VedantPahariya/VLSI-Carry-Look-Ahead-Adder/Project Report.pdf

# Fastest Carry Look-Ahead Adder Design for Enhanced Computational Efficiency

Vedant Pahariya
ECD IIIT-H
2023112012
vedant.pahariya@research.iiit.ac.in

Abstract—This paper proposes the design for the fastest CLA. It mentions about all the blocks and topology used in the design. It also mentions about the simulation results and the comparison with existing designs. The design is implemented in 180nm technology. The design is compared with the existing designs and it is found that the proposed design is the fastest among all.

Index Terms—Carry Look-Ahead Adder, CLA, VLSI, Computational Efficiency, 180nm Technology, Digital Design, High-Speed Arithmetic

I. INTRODUCTION

The Carry Look-Ahead Adder (CLA) is a digital circuit that is used to add two binary numbers. It is a basic unit component for all arithmetic processes which goes in processor. Making it faster can enhance the computational efficiency of whole system. The CLA is a fast adder because it can generate the carry signals for all the bits in parallel. The CLA is faster than the Ripple Carry Adder (RCA) because the RCA generates the carry signals sequentially, faster than the Carry Select Adder (CSA) because the CSA generates the carry signals for a group of bits in parallel, faster than the Carry Skip Adder (CSKA) because the CSKA generates the carry signals for a group of bits in parallel, faster than the Carry Increment Adder (CIA) because the CIA generates the carry signals for a group of bits in parallel.

II. CARRY LOOK-AHEAD ADDER DESIGN

CLA design consists of three blocks: the Propagate & Generate block, Carry Look Ahead (CLA) block and Sum block. The Propagate & Generate block gives carry generate (Gi) and propagate generate (Pi) signal for every i

th bit of inputs. The
output of this block is used in CLA block to generate Carry Ci which is then utilised in the Sum block to get the Sum output. The basic CLA design is based on the following equations:

Gi = Ai

- Bi | (1)
Pi = Ai ⊕ Bi | (2)

Ci = Gi + Pi

- Ci−1 | (3)

where Gi
is the Generate signal, Pi is the Propagate signal,
Ci

is the Carry signal, Ai
is the i

th bit of the first number, Bi is the i

th bit of the second number, and Ci−1 is the (i − 1)th Carry signal.

Here, we are focusing on the 4-bit CLA design. Therefore, using recursive approach for carry in above equations, we can write the equations for the 4-bit CLA design as follows:

C0 = G0 + P0 · Cin | (4)

C1 = G1 + P1 · C0
= G1 + P1 · (G0 + P0 · Cin)
= G1 + P1 · G0 + P1 · P0 · Cin | (5)

C2 = G2 + P2 · C1
= G2 + P2 · (G1 + P1 · (G0 + P0 · Cin))
= G2 + P2 · G1 + P2 · P1 · G0 + P2 · P1 · P0 · Cin (6)

C3 = G3 + P3 · C2
= G3 + P3 · (G2 + P2 · (G1 + P1 · (G0 + P0 · 0)))
= G3 + P3 · G2 + P3 · P2 · G1 + P3 · P2 · P1 · G0 (7)

where Ci

, Gi
, and Pi are the Carry, Generate, and Propagate signals for the i

th bit, respectively. Cin is the input Carry signal.

A. Improving the Basic CLA Design

The above basic CLA design can be improved extensively by making the following changes:
1) Use of OR gate instead of XOR gate for Propagate block: XOR gate can be replaced by OR gate which can be further reduced to the NOR logic for the Propagate block to reduce the number of gates in the design. The Propagate block can be designed as follows:
Pi = Ai + Bi | (8)

To demonstrate that both XOR and OR gates give the same results for the Propagate block, we can see in the following truth table that results are same for both XOR and OR gates except when both inputs are 1.

TABLE I
TRUTH TABLE FOR XOR AND OR GATES
Ai | Bi | Ai ⊕ Bi (XOR) | Ai + Bi (OR)
0 | 0 | 0 | 0
0 | 1 | 1 | 1
1 | 0 | 1 | 1
1 | 1 | 0 | 1

In case of carry generation, when both inputs are High (1), that is both Ai = 1 and Bi = 1:

Gi = Ai

- Bi = 1 · 1 = 1
Ci = Gi + Pi
- Ci−1
= 1 + Pi
- Ci−1
= 1 (regardless of Pi and Ci−1)

Therefore, when both inputs are 1, the carry signal is always generated (Ci = 1) regardless of the value of the propagate signal (Pi) or the previous carry (Ci−1).
As shown above, for the purpose of carry propagation in the CLA design, the OR gate can be used in place of XOR to reduce the number of gates.
2) Modification of the equations for the Carry signals to reduce the number of gates: The equations for the Carry signals for basic CLA use AND and OR gates which inherently includes two extra transistors for each gate becuase of the presence of the inverter. The number of gates can be reduced by modifying the logic such that it uses NAND and NOR gates in place of AND and OR wherever possible. Starting with simplification of C1, we know that:

C1 = G0 + P0 · C0

Here, we can convert AND gate between P0, C0 to NOR gate as shown below:

C1 = G0 +

P

′
0 + C0

Further, we can convert OR gate to NAND gate as shown below:
C1 = G′
0
P

′
0 + C0

Similarly, for the other carry signals, the modified equations can be written as follows:

C1 = G′
0
P

′
0 + C0
(9)

C2 = G′
1

(P

′

1 + G′
0

) +
P

′
1 + P

′
0
C0 | (10)

C3 = G′
2

(P

′

2 + G′
1

) +
P

′
2 + P

′
1
G′
0
P

′
0 + C0
(11)

G

′
out = G′
3

(P

′

3 + G′
2

) +
P

′
3 + P

′
2
G′
1

(P

′

1 + G′
0

) (12)

P

′
out = (P

′
3 + P

′
2

)(P

′
1 + P

′
0
) | (13)

C4 = G′
out
P

′
out + C0
| (14)

where G′
i

and P

′
i

are the modified Generate and Propagate signals for the i

th bit, respectively.

B. Topology and Sizing of Each Block
Based on the equations and logic functions derived above, the topology of the 4-bit CLA design can be implemented as shown in the figure below. The design is implemented in 180nm technology. The sizing of the transistors in each block is done considering the speed of the design. I have followed the CMOS logic for all the logic gates except XOR. For XOR, I used Pass Transistor Logic because it uses less no. of transistors. Here, I implemented the method of logical effort for sizing each block as following:

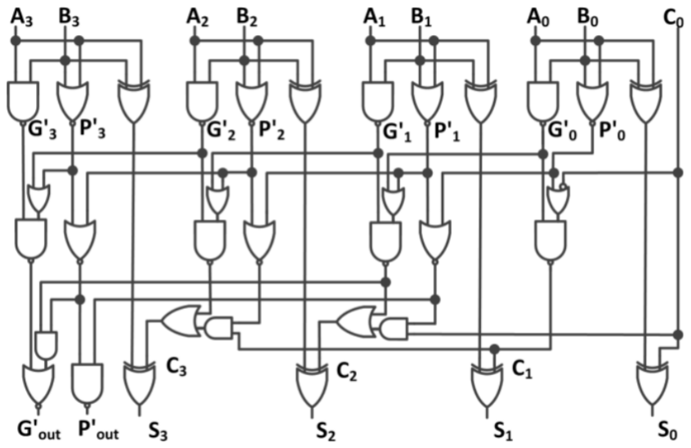
[picture p2: figure]

Fig. 1. 4-bit Carry Look-Ahead Adder Design

1) Propagate & Generate Block: This block includes three gates for each carry bit: One NOR gate for the Propagate signal, one NAND gates for the Generate signal and one XOR gate for the Sum signal.

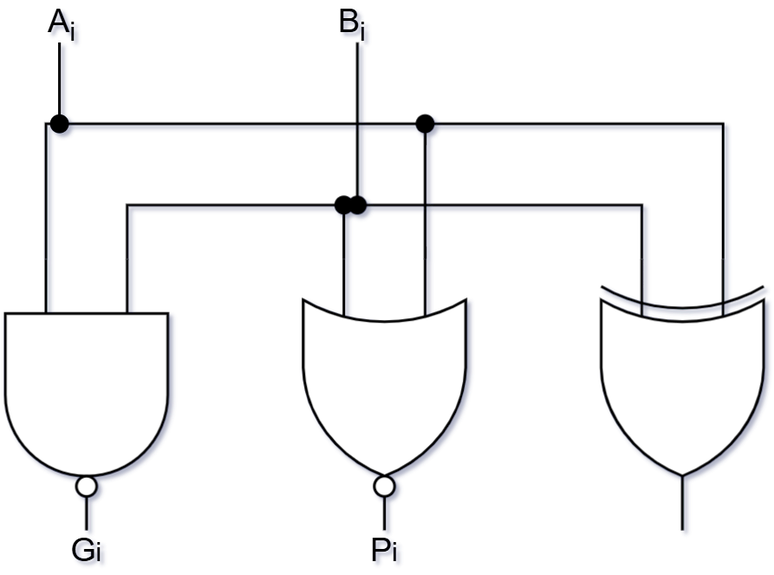
[picture p3: figure]

Fig. 2. Propagate & Generate Block

Accoroding to the method of logical effort, the size of these gates is larger i.e. just double the proceedings gates of the intermediate block of CLA. So, the table below shows the sizing of gates in this block:

TABLE II
SIZING OF GATES IN PROPAGATE & GENERATE BLOCK
Gate | Width (WN /WP ) (µm) | Length (µm) | Number of Gates
NOR | 3.6 / 7.2 | 0.18 | 4
NAND | 3.6 / 3.6 | 0.18 | 4
XOR | 0.36 / 0.72 | 0.18 | 4
2) Carry Look Ahead Block: This block again further divided into two more subblocks namely intermediate block and AndOr block. The intermediate and the AndOr block includes three gates and two gates respectively for each carry bit. The intermediate block includes a NOR gate, NAND and OR gate and the AndOr block includes one AND gate and one OR gate.

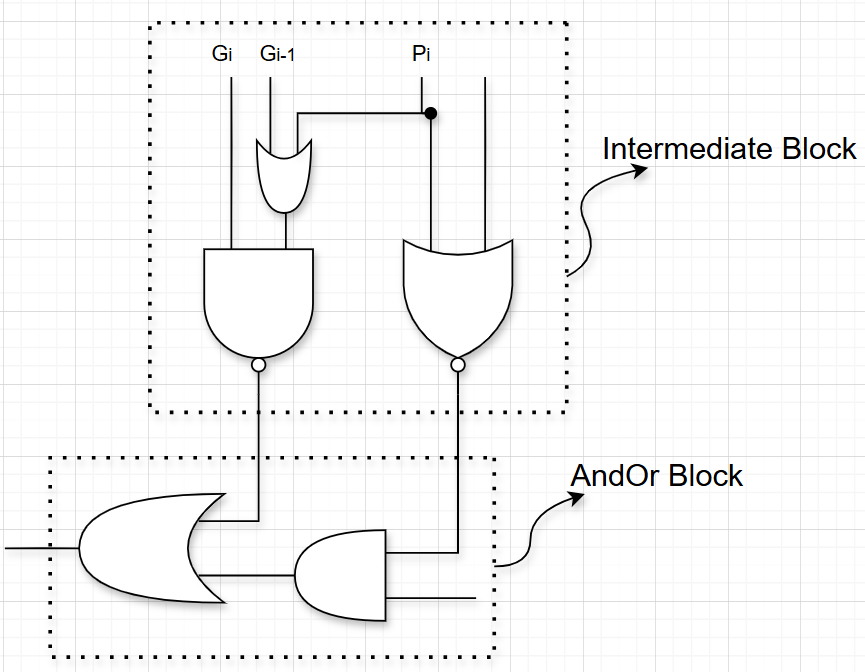
[picture p4: figure]

Fig. 3. Carry Look Ahead Block for Single Carry Bit

The sizing of gates in the intermediate and AndOr block is done as per the method of logical effort. As a result, also mentioned in the previous block that this block sizing is half of the propagate & generate block sizing. The OR gate is implemented using the NOR gate with an inverter at the output. Similarly for the AND gate, the NAND gate is used with an inverter at the output. The table below shows the sizing of gates in these blocks:

TABLE III
SIZING OF GATES IN INTERMEDIATE AND ANDOR BLOCKS
Block | Gate | Width (WN /WP ) (µm) | Length (µm)
Intermediate | NOR | 0.9 / 1.8 | 0.18
| NAND | 1.8 / 1.8 | 0.18
| OR | 0.9 / 1.8 | 0.18
AndOr | AND | 1.8 / 1.8 | 0.18
| OR | 0.9 / 1.8 | 0.18
Inverter | - | 0.9 / 1.8 | 0.18
3) Sum Block: This block includes single XOR gate for the Sum signal which is implemented using Pass Transistor Logic. The sizing of this is set to be least possible just enough to drive the W-sized inverter and satisfy the DRC constraints because it is the last block in the design and don’t have to drive any other block.

Fig. 4. Sum Block

TABLE IV
SIZING OF GATES IN SUM BLOCK
Gate | Width (WN /WP ) (µm) | Length (µm) | Number of Gates
XOR | 0.36 / 0.72 | 0.18 | 6
4) D-Flip Flop: It is implemented using the True Single Phase Clocked (TSPC) technology. It includes total no. of 12 transistors in CMOS logic style. The sizing of this is done by equating the resistances with the minimum W-sized inverter. There are two parts in the postive edge trigerred TSPC D-Flip Flop: Low-Level Latch and High-Level Latch.

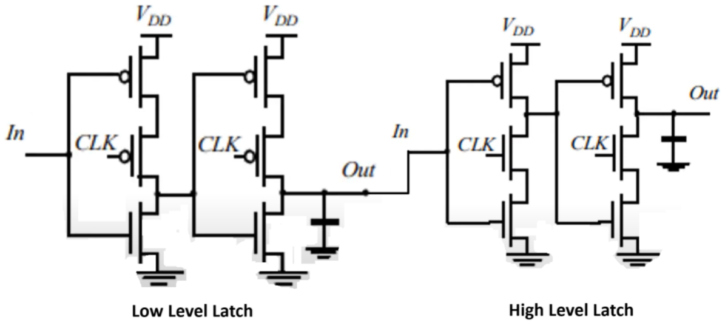
[picture p5: figure]

Fig. 5. TSPC D-Flip Flop

TABLE V
SIZING OF TRANSISTORS IN TSPC D-FLIP FLOP
Block | Transistor | Width (µm) | Length (µm)
Low-Level Latch | PMOS | 3.6 | 0.18
| NMOS | 0.9 | 0.18
High-Level Latch | PMOS | 1.8 | 0.18
| NMOS | 1.8 | 0.18

III. DELAY CHARACTERISTICS OF D-FLIP FLOP (PRELAYOUT)

The TSPC D Flip-Flop was simulated using NGSPICE with a clock period of 2ns and input period of 4ns. Both clock and input signals were given sharp rise/fall times of 50ps to analyze the flip-flop’s delay characteristics.

A. Clock to Q Delay

Upon simulating, we observe the following waveforms and terminal outputs:

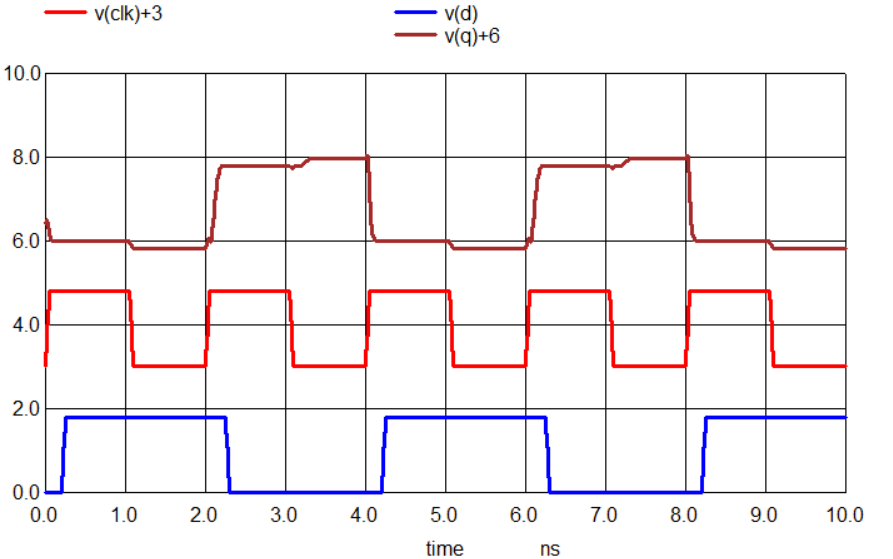
[picture p6: figure]

Fig. 6. Waveforms Output of D-Flip Flop

Fig. 7. Terminal Output for Delay

The simulation gives the following timing parameters:

- Rise Delay: 91.58ps - Time taken for the output to rise after the triggering clock edge
- Fall Delay: 30.77ps - Time taken for the output to fall after the triggering clock edge
- Average Propagation Delay: 61.17ps - Mean of rise and fall delays

The asymmetry between rise and fall delays (ratio ≈ 3:1) can be attributed to:

- Different sizing of PMOS/NMOS transistors in the low-level and high-level latches
- Inherent mobility difference between PMOS and NMOS devices
- Cascaded structure of the latches affecting signal propagation paths
B. Setup Time

Setup time (tsetup) is the minimum time before the active clock edge during which the data input (D) must remain stable. For TSPC D flip-flop, setup time is equal to the propagation delay of the Low-Level Latch because when clock is low, the Low-Level Latch is active and as it rises to high, the correct stable value of D must be present at the output of the Low-Level Latch for ensuring correct operation. This stable value of D appears at the output of the Low-Level Latch after the propagation delay of the Low-Level Latch.

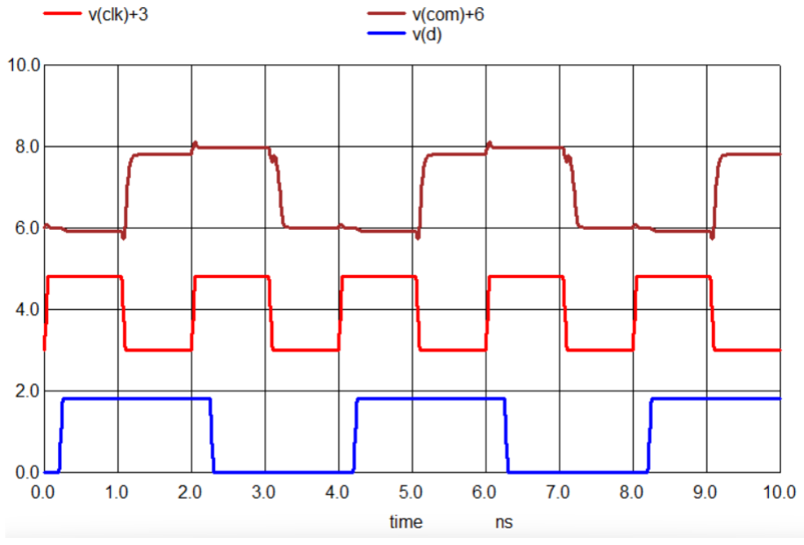
[picture p7: figure]

Fig. 8. Waveforms Output of Low-Level Latch

Fig. 9. Terminal Output for Setup Time

C. Hold Time

Hold time (thold) is the minimum time after the active clock edge during which the data input must remain stable. For TSPC D flip-flop, hold time is zero because the High-Level Latch is active when the clock is high and the output of the High-Level Latch is not dependent on the input D when the clock is high. Therefore, the input D can change immediately after the active clock edge without affecting the output Q.

TABLE VI
TIMING CHARACTERISTICS OF TSPC D-FLIP FLOP
Parameter | Value (ps)
Rise Delay | 91.58
Fall Delay | 30.77
Propagation Delay | 61.17
Setup Time | 87.65
Hold Time | 0

IV. STICK DIAGRAM OF UNIQUE GATES

A. Inverter

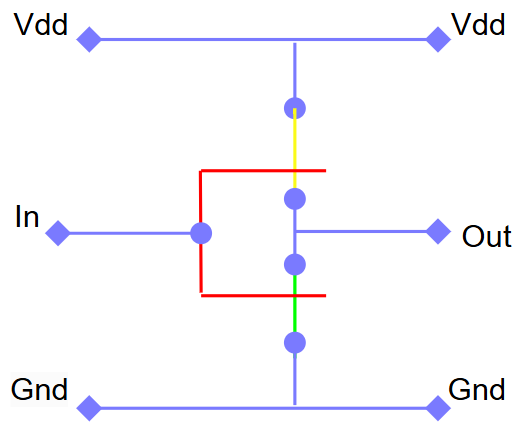
[picture p8: figure]

Fig. 10. Inverter Stick Diagram

B. NOR Gate

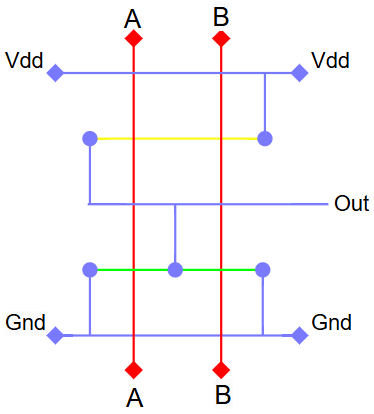
[picture p9: figure]

Fig. 11. NOR Gate Stick Diagram

C. NAND Gate

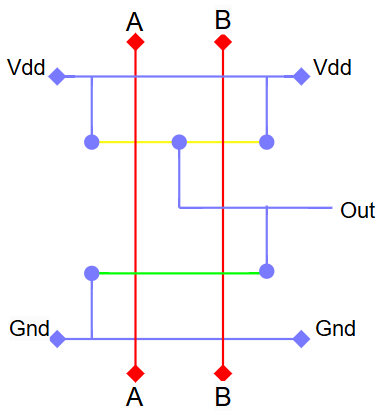
[picture p10: figure]

Fig. 12. NAND Gate Stick Diagram

D. XOR Gate

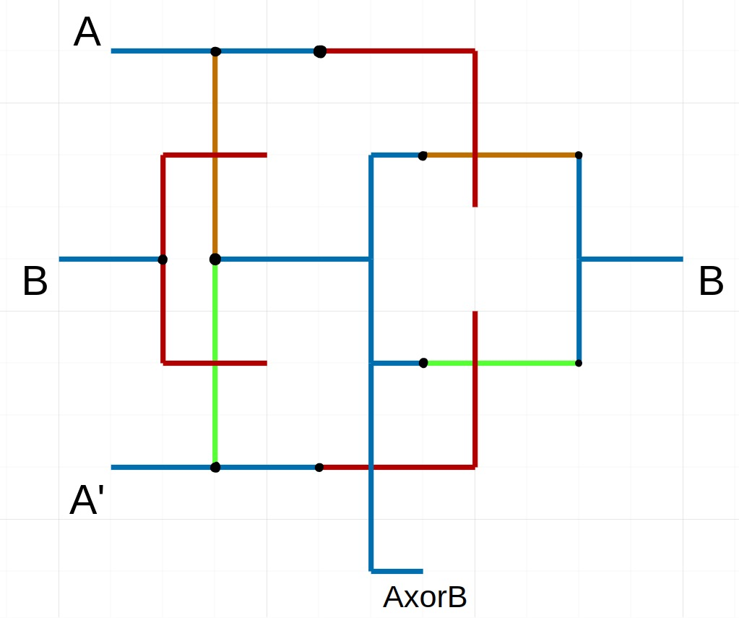
[picture p11: figure]

Fig. 13. XOR Gate Stick Diagram

V. PRELAYOUT SIMULATION RESULTS & ANALYSIS OF
CLA
The 4-bit Carry Look-ahead Adder was simulated using NGSPICE with the following test conditions:
A. Verification of functionality
1) Input Specifications:
- Supply Voltage (VDD): 1.8V
- Input A (4-bit):

– A0: Pulse starting at 10ns, Period = 40ns – A1: Pulse starting at 15ns, Period = 50ns – A2: Pulse starting at 20ns, Period = 60ns – A3: Pulse starting at 25ns, Period = 70ns – Rise/Fall times: 50ps
- Input B (4-bit):
– B0: Pulse starting at 12ns, Period = 44ns – B1: Pulse starting at 18ns, Period = 56ns – B2: Pulse starting at 24ns, Period = 68ns
– B3: Pulse starting at 30ns, Period = 80ns
– Rise/Fall times: 50ps
- Carry Input (Cin): Pulse starting at 36ns, Period = 88ns
- Clock (CLK): Period = 8ns
2) Output Analysis: The simulation produces the following outputs:
- Sum outputs (S0-S3): Generated through XOR combinations of inputs and internal carries
- Final Carry (C4): Represents the overflow from the 4-bit addition

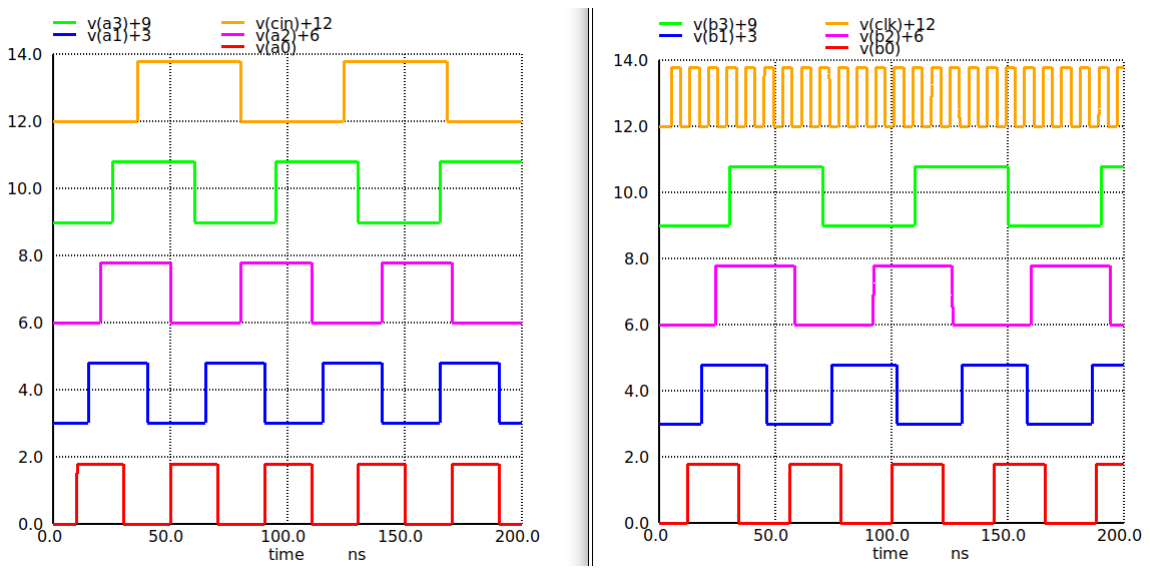
[picture p12: figure]

Fig. 14. Input Waveform

Above plots show the input waveforms given to the 4-bit CLA. The left plot shows the A bits along with Cin and right one shows the B bits along with the clock.

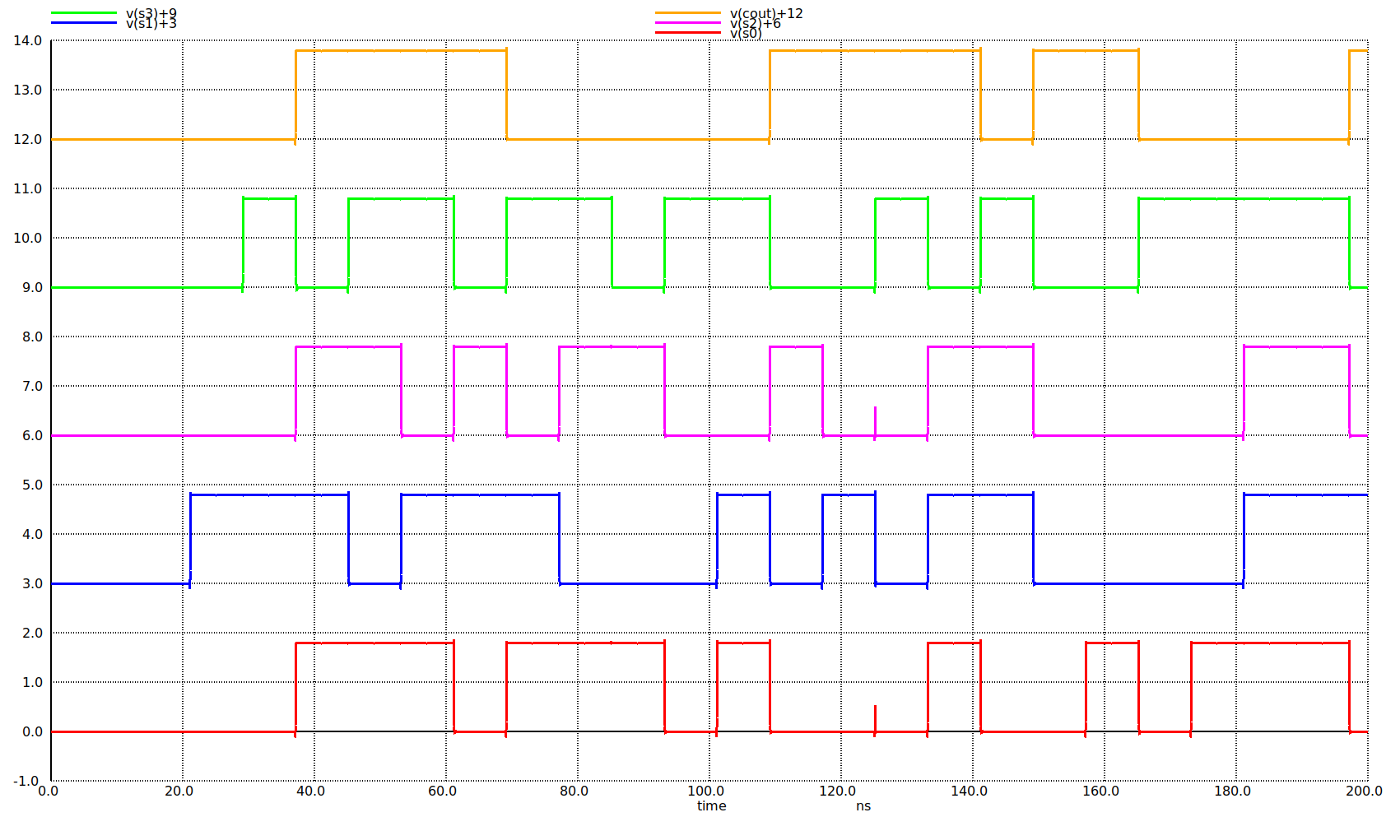
[picture p13: figure]

Fig. 15. Output Waveform

Above plot shows the output waveforms which includes the four Sum bits and the final Carry bit.
The waveforms demonstrate correct operation of the CLA with proper carry propagation and sum generation across all bit positions. The progressive delays in input signals help verify the adder’s functionality under varying timing conditions.
B. Worst Case Delay of CLA Adder Block

Worst case delay is the maximum time taken for the output to stabilize after the input changes. This happens in the path which has highest resistance or very large number of gates. In the 4-bit CLA design proposed above, the worst case delay is observed in the carry propagation path from B0 through C3 to S3 because it is the longest path with total 9 gates in midway. For considering the worst case delay, the S3 bit must change when B0 bit changes. So, here we take the input signals as follows:
- A0 = A1 = A2 = A3 = 0, B1 = B2 = 1, B3 = 0
- B0: Pulse starting at 25ns, Period = 70ns
- Cin = 1
- Clock (CLK): Pulse starting at 0ns, Period = 8ns
With the above inputs, we get the simulation results for the worst case delay as follows:

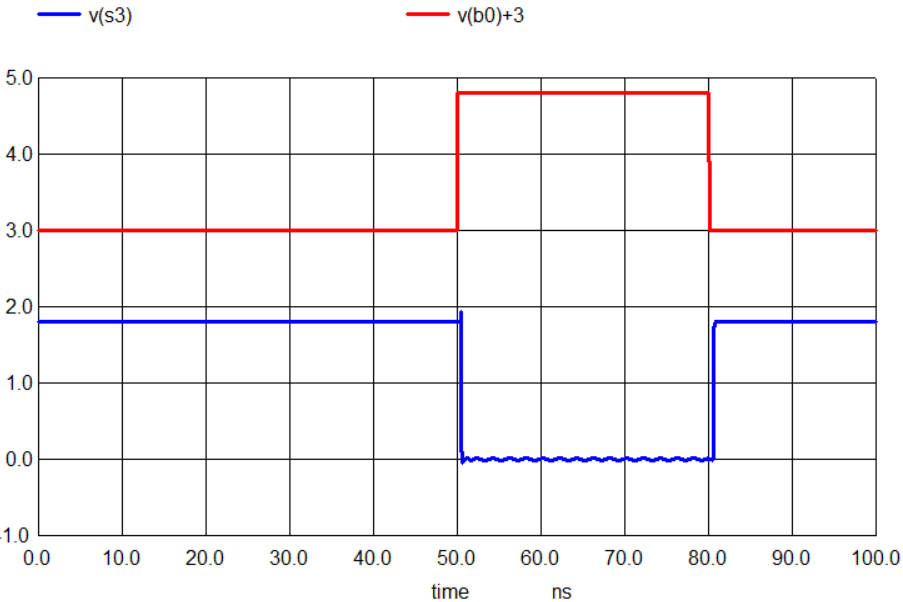
[picture p14: figure]

Fig. 16. WaveForms for the Worst Case Delay

Fig. 17. Worst Case Delay Terminal Output

The simulation results show that the worst case delay for the 4-bit CLA design is 479.16ps. This delay is observed in the carry propagation path from B0 through C3 to S3.

C. Maximum Clock Speed
1) Theoritical Calculation: The maximum clock speed of the 4-bit CLA design can be calculated using the following inequality:
tCQ1 + tpd + tsu ≤ Tclk | (15)

fmax =

1 tCQ1 + tpd + tsu | (16)

where tCQ1

is the clock-to-Q delay of the first flip-flop, tpd is the worst-case propagation delay of the CLA adder block, and tsu is the setup time of the flip-flop.
Given the values we calculated earlier:
- tCQ1 = 61.17 ps
- tpd = 479.16 ps
- tsu = 87.65 ps

The maximum clock frequency is:

fmax =

1
61.17 ps + 479.16 ps + 87.65 ps

≈ 1.59 GHz

(17)
2) Found using Simulation: Using the Ngspice Simulation, I found that the maximum clock frequency of the 4-bit CLA design is 1.04 GHz which is less than the theoritical value. This difference can be attributed to the following factors:
- Parasitic Capacitances: The simulation does not consider the parasitic capacitances which can affect the delay and hence the maximum clock frequency.
- Wire Delays: The simulation does not consider the wire delays which can affect the delay and hence the maximum clock frequency.

VI. DELAY CHARACTERISTICS OF D-FLIP FLOP (POSTLAYOUT)

The TSPC D Flip-Flop was simulated using NGSPICE with a clock period of 2ns and input period of 4ns. Both clock and input signals were given sharp rise/fall times of 50ps to analyze the flip-flop’s delay characteristics.

A. Clock to Q Delay

Upon simulating, we observe the following waveforms and terminal outputs:
The simulation gives the following timing parameters:
- Rise Delay: 92.21ps - Time taken for the output to rise after the triggering clock edge
- Fall Delay: 24.09ps - Time taken for the output to fall after the triggering clock edge
- Average Propagation Delay: 53.15ps - Mean of rise and fall delays
- Setup Time: 67.43ps - Minimum time before the active clock edge during which the data input must remain stable
- Hold Time: 0ps - Minimum time after the active clock edge during which the data input must remain stable

VII. POST-LAYOUT SIMULATION RESULTS & ANALYSIS
OF CLA

The 4-bit CLA desgign layout was implemented in 180nm technology in magic as shown in the figure below. The layout was then extracted and simulated using NGSPICE with the same test conditions as the pre-layout simulation.


Fig. 18. Magic Layout of 4-bit CLA Design

A. Verification of functionality

The input and output specifications are same as mentioned previously in the prelayout simulation. The post-layout simulation produces the following outputs:

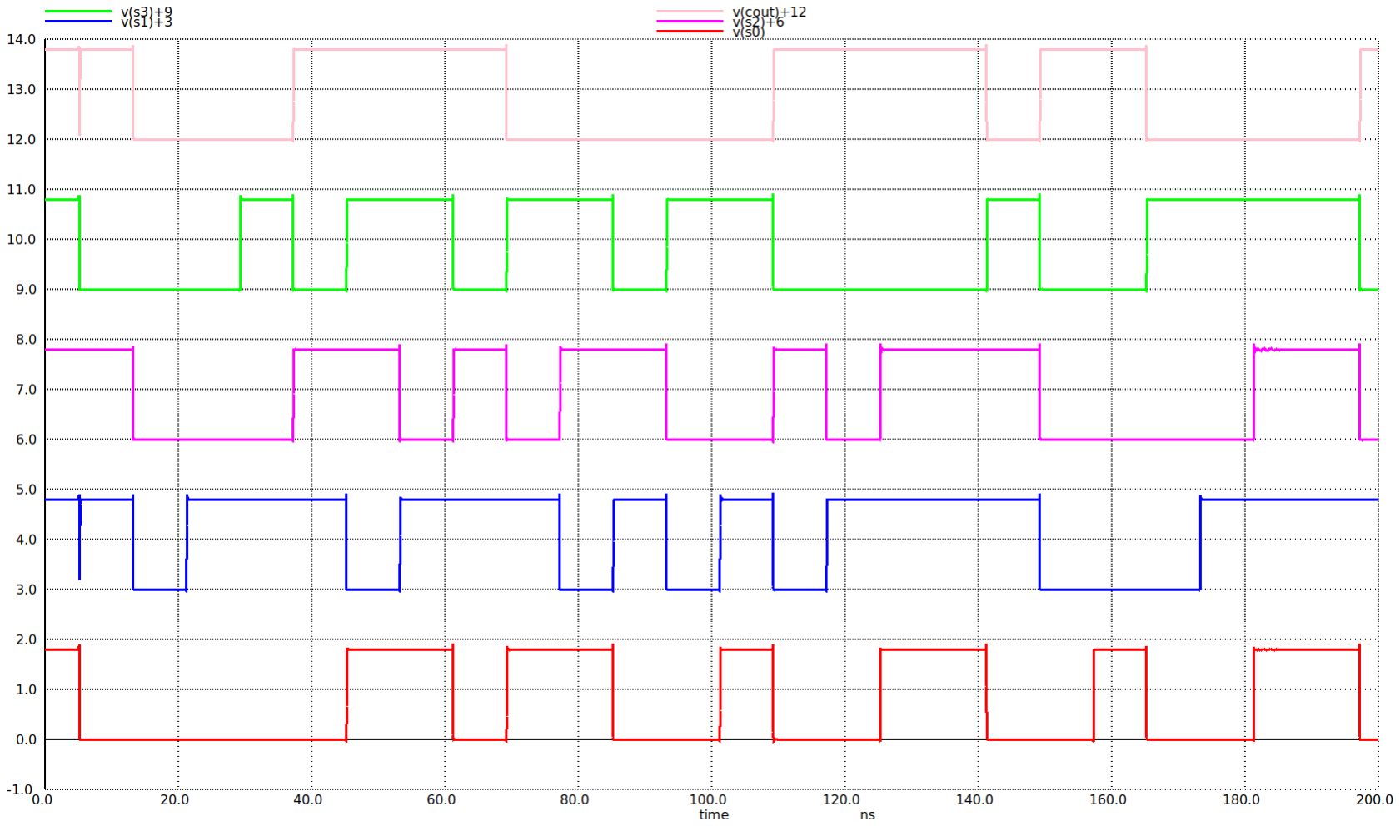
[picture p15: figure]

Fig. 19. Input Waveform

The intial outputs are different from the prelayout simulation because of the initial conditions of the flip-flops. After few clock cycles, the outputs stabilize and matches exactly with the prelayout simulation hence the correct operation of the CLA is verified.

B. Worst Case Delay of CLA Adder Block

The worst case delay of the post-layout 4-bit CLA design is calculated using the same inputs as in the pre-layout simulation. The simulation results for the worst case delay are as follows:

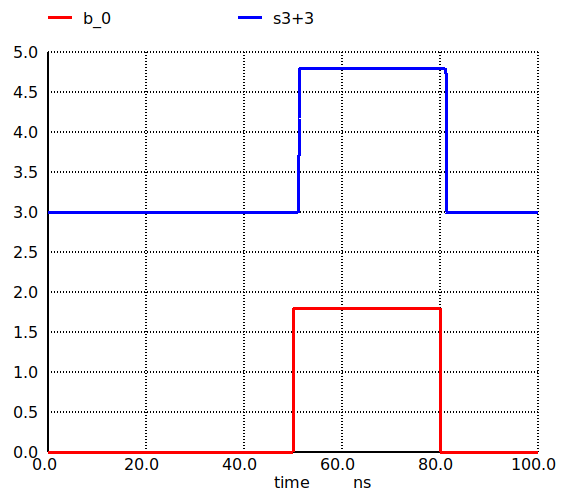
[picture p16: figure]

Fig. 20. WaveForms for the Worst Case Delay

Fig. 21. Worst Case Delay Terminal Output

The simulation results show that the worst case delay for the post-layout 4-bit CLA design is 1112.62ps. This delay is observed in the carry propagation path from B0 through C3 to S3.

C. Maximum Clock Speed

The maximum clock speed of the post-layout 4-bit CLA design is calculated using the same method as in the pre-layout simulation. Given the values we calculated earlier:

- tCQ1 = 53.15 ps
- tpd = 1112.62 ps
- tsu = 67.43 ps

The maximum clock frequency is:

fmax =

1
53.15 ps + 1112.62 ps + 67.43 ps

≈ 0.81 GHz

(18)
By using the simulation, we found out the similar results as calculated above. The maximum clock frequency of the post-layout 4-bit CLA design is 0.81 GHz.

TABLE VII
COMPARISON OF PRE AND POST LAYOUT SIMULATION RESULTS
Parameter | Pre-Layout | Post-Layout
Worst Case Delay (ps) | 479.16 | 1112.62
Maximum Clock Frequency (GHz) | 1.59 | 0.81

VIII. FLOOR PLAN FOR COMPLETE CIRCUIT LAYOUT

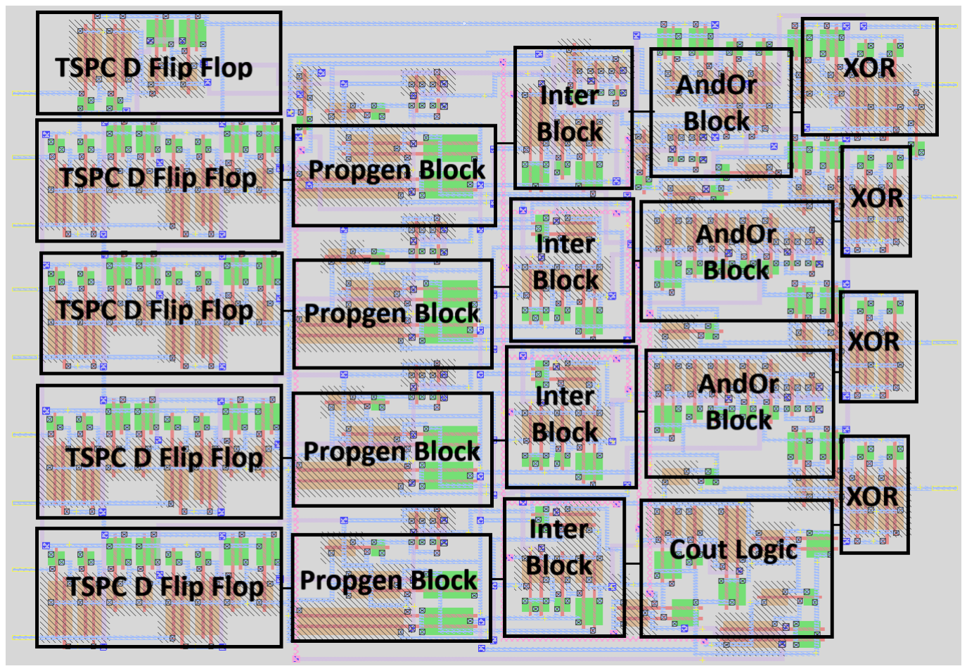
[picture p17: figure]

Fig. 22. Floor Plan for Complete Circuit Layout

The floor plan for the complete circuit layout is shown in the figure above. The layout is divided into four blocks: Propagate & Generate, Intermediate, AndOr, and Sum/XOR. The blocks are placed in a compact and organised manner to minimize the area of the layout. The Vertical and Horizontal pitch of the layout is shown in the figure below:

Fig. 23. Horizontal and Vertical pitch

From the above figure data, the area of the complete circuit layout is calculated as follows:

Area = Horizontal Pitch × Vertical Pitch
= 61.56µm × 43.83µm
= 2698.18µm²

IX. VERILOG HDL SIMULATION RESULTS

This GTKWave plot illustrates the simulation of a 4-bit Carry-Lookahead Adder (CLA). The inputs are:
- A[3 : 0]: A 4-bit binary number. - B[3 : 0]: Another 4-bit binary number. - Cin: The carry-in input.
The outputs are:
- S[3 : 0]: The 4-bit sum. - Cout: The carry-out signal. For example, at t = 0 ns:

A = 8 (10002), B = 7 (01112), Cin = 1.

The resulting sum is:

S = A + B + Cin = 8 + 7 + 1 = 16 (100002).

This gives:

S[3 : 0] = 0 (lower 4 bits), Cout = 1 (carry-out).

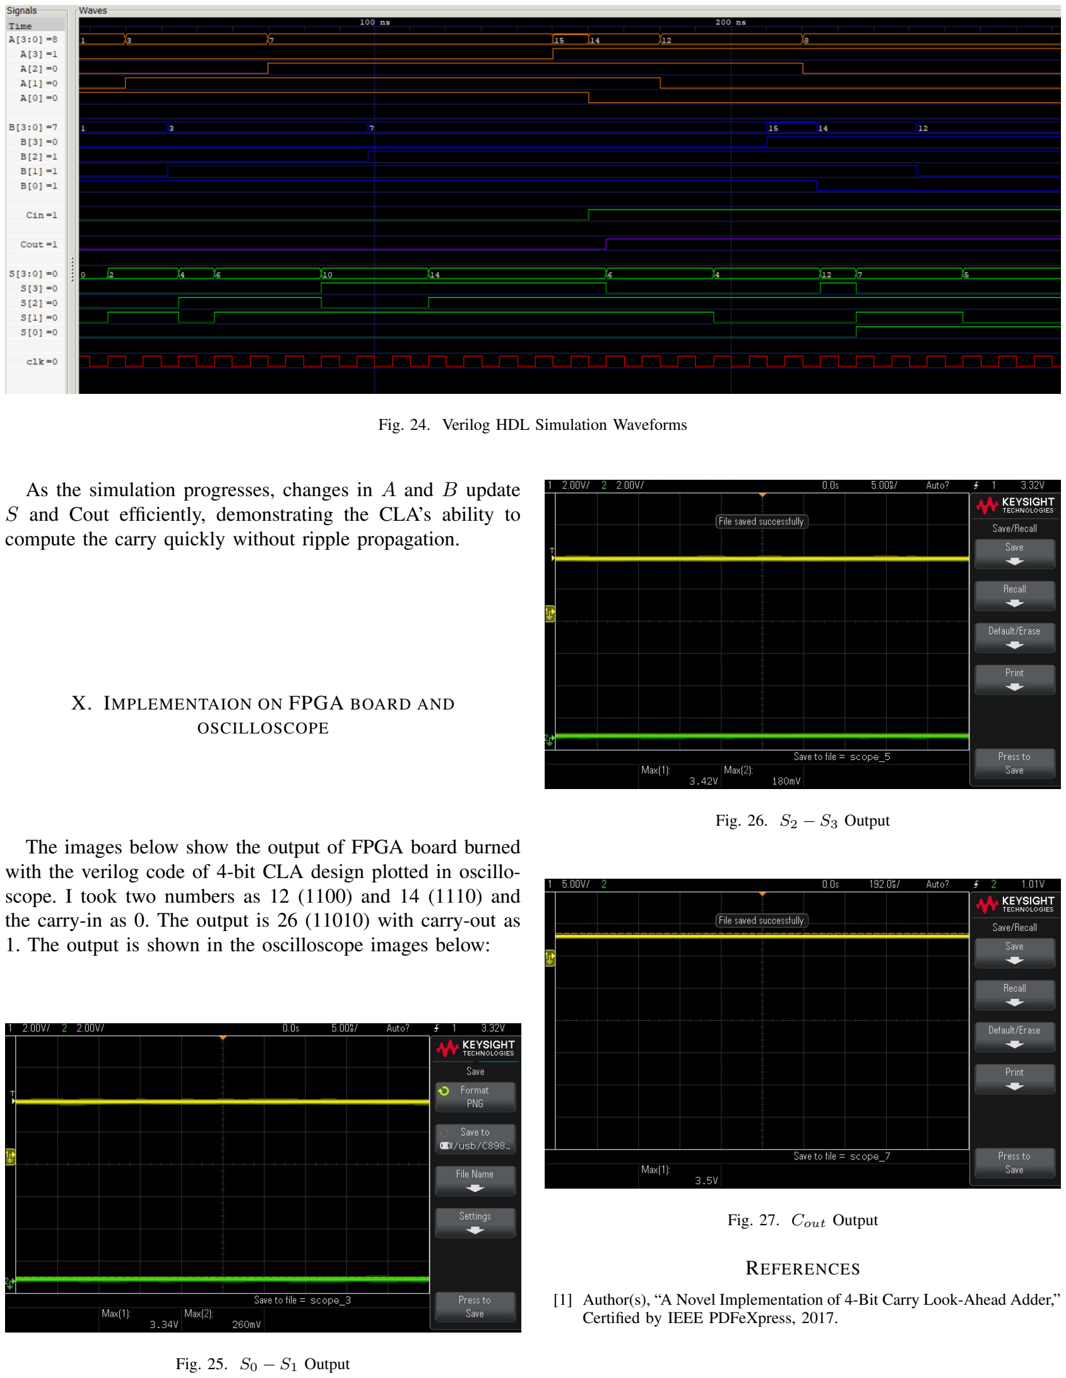
[picture p18: page 9]

Fig. 24. Verilog HDL Simulation Waveforms

As the simulation progresses, changes in A and B update S and Cout efficiently, demonstrating the CLA’s ability to compute the carry quickly without ripple propagation.

X. IMPLEMENTAION ON FPGA BOARD AND

OSCILLOSCOPE

The images below show the output of FPGA board burned with the verilog code of 4-bit CLA design plotted in oscilloscope. I took two numbers as 12 (1100) and 14 (1110) and the carry-in as 0. The output is 26 (11010) with carry-out as
1. The output is shown in the oscilloscope images below:

Fig. 25. S0 − S1 Output

Fig. 26. S2 − S3 Output

Fig. 27. Cout Output

REFERENCES

[1] Author(s), “A Novel Implementation of 4-Bit Carry Look-Ahead Adder,” Certified by IEEE PDFeXpress, 2017.
