VedantPahariya/VLSI-Carry-Look-Ahead-Adder/Magic/TSPC2.cir

.include TSMC_180nm.txt
.param SUPPLY=1.8
.global gnd vdd

* Supply
Vdd vdd gnd 'SUPPLY'

* SPICE3 file created from TSPC2.ext - technology: scmos

.option scale=0.09u

M1000 a_380_n536# clk a_380_n568# Gnd CMOSN w=20 l=2
+  ad=100 pd=50 as=80 ps=48
M1001 a_380_n568# mid gnd Gnd CMOSN w=20 l=2
+  ad=0 pd=0 as=300 ps=160
M1002 a_402_n568# a_380_n536# gnd Gnd CMOSN w=20 l=2
+  ad=80 pd=48 as=0 ps=0
M1003 a_380_n536# mid VDD w_323_n542# CMOSP w=20 l=2
+  ad=100 pd=50 as=600 ps=280
M1004 Q clk a_402_n568# Gnd CMOSN w=20 l=2
+  ad=100 pd=50 as=0 ps=0
M1005 Q a_380_n536# VDD w_323_n542# CMOSP w=20 l=2
+  ad=100 pd=50 as=0 ps=0
M1006 mid clk a_358_n536# w_323_n542# CMOSP w=40 l=2
+  ad=200 pd=90 as=160 ps=88
M1007 a_358_n536# a_336_n558# VDD w_323_n542# CMOSP w=40 l=2
+  ad=0 pd=0 as=0 ps=0
M1008 a_336_n558# clk a_336_n536# w_323_n542# CMOSP w=40 l=2
+  ad=200 pd=90 as=160 ps=88
M1009 a_336_n536# D VDD w_323_n542# CMOSP w=40 l=2
+  ad=0 pd=0 as=0 ps=0
M1010 mid a_336_n558# gnd Gnd CMOSN w=10 l=2
+  ad=50 pd=30 as=0 ps=0
M1011 a_336_n558# D gnd Gnd CMOSN w=10 l=2
+  ad=50 pd=30 as=0 ps=0
C0 Q w_323_n542# 0.03fF
C1 w_323_n542# mid 0.09fF
C2 w_323_n542# clk 0.45fF
C3 mid clk 0.33fF
C4 w_323_n542# D 0.06fF
C5 D clk 0.03fF
C6 w_323_n542# VDD 0.08fF
C7 mid VDD 0.08fF
C8 VDD clk 0.21fF
C9 mid gnd 0.06fF
C10 a_380_n536# w_323_n542# 0.11fF
C11 gnd clk 0.36fF
C12 a_380_n536# clk 0.09fF
C13 w_323_n542# a_336_n558# 0.09fF
C14 a_336_n558# clk 0.03fF
C15 D VDD 0.06fF
C16 D gnd 0.04fF
C17 a_380_n568# gnd 0.01fF
C18 a_380_n536# VDD 0.02fF
C19 a_358_n536# VDD 0.01fF
C20 a_380_n536# gnd 0.02fF
C21 a_336_n536# VDD 0.01fF
C22 a_336_n558# VDD 0.08fF
C23 a_336_n558# gnd 0.04fF
C24 gnd Gnd 0.16fF
C25 Q Gnd 0.05fF
C26 a_380_n536# Gnd 0.11fF
C27 mid Gnd 0.13fF
C28 VDD Gnd 0.00fF
C29 a_336_n558# Gnd 0.16fF
C30 clk Gnd 0.36fF
C31 D Gnd 0.12fF
C32 w_323_n542# Gnd 3.94fF

* Clock Pulse
vclk clk gnd pulse 0 1.8 0ns 50ps 50ps 1ns 2ns

* Input Pulse D
vin D gnd pulse 0 1.8 0.2ns 50ps 50ps 2ns 4ns
* initial voltage, peak volt, delay, rise time, fall time, pulse width, period

.tran 0.01ns 15ns

.measure tran rise_delay
+ TRIG v(clk) VAL='SUPPLY/2' RISE=2
+ TARG v(Q) VAL='SUPPLY/2' RISE=1

.measure tran fall_delay
+ TRIG v(clk) VAL='SUPPLY/2' RISE=3
+ TARG v(Q) VAL='SUPPLY/2' FALL=2

.measure tran propogation_delay param='(rise_delay + fall_delay)/2'

.control
set color0= white
set color1= black
set color2= brown
set color3= red
set color4= blue
set xbrushwidth=3

run
plot v(Q)+6 v(clk)+3 v(D)  title "Output Q"
.endc
