VedantPahariya/VLSI-Carry-Look-Ahead-Adder/Magic/Finals/clk.cir

.include TSMC_180nm.txt
.param SUPPLY=1.8
.global gnd vdd

* Supply
Vdd vdd gnd 'SUPPLY'

* SPICE3 file created from clkcla.ext - technology: scmos

.option scale=0.09u

M1000 a_296_n76# clk a_278_n59# w_243_n62# CMOSP w=40 l=2
+  ad=160 pd=88 as=200 ps=90
M1001 a_n260_n227# clk a_n260_n195# Gnd CMOSN w=20 l=2
+  ad=100 pd=50 as=80 ps=48
M1002 gnd B_0 Pt0 Gnd CMOSN w=40 l=2
+  ad=9445 pd=4856 as=400 ps=180
M1003 VDD a_300_n163# a_296_n160# w_137_n171# CMOSP w=40 l=2
+  ad=18200 pd=8590 as=160 ps=88
M1004 a_44_n222# G0 gnd Gnd CMOSN w=10 l=2
+  ad=100 pd=60 as=0 ps=0
M1005 a_150_n274# C1 VDD w_137_n280# CMOSP w=20 l=2
+  ad=120 pd=52 as=0 ps=0
M1006 a_n172_n437# a_n194_n405# VDD w_n317_n463# CMOSP w=20 l=2
+  ad=100 pd=50 as=0 ps=0
M1007 a_n304_n405# clk a_n304_n457# w_n317_n463# CMOSP w=40 l=2
+  ad=200 pd=90 as=160 ps=88
M1008 a_n101_n391# A_3 VDD w_n131_n463# CMOSP w=20 l=2
+  ad=100 pd=50 as=0 ps=0
M1009 a_198_n75# clk a_180_n58# w_123_n108# CMOSP w=40 l=2
+  ad=160 pd=88 as=200 ps=90
M1010 a_190_n274# a_174_n296# VDD w_137_n280# CMOSP w=20 l=2
+  ad=120 pd=52 as=0 ps=0
M1011 a_n216_n405# B3 gnd Gnd CMOSN w=10 l=2
+  ad=50 pd=30 as=0 ps=0
M1012 a_174_n405# a_150_n383# VDD w_137_n389# CMOSP w=20 l=2
+  ad=100 pd=50 as=0 ps=0
M1013 s_0 C0 pgxor0 w_38_n97# CMOSP w=8 l=2
+  ad=80 pd=52 as=120 ps=78
M1014 gnd a_278_n59# a_274_n24# Gnd CMOSN w=20 l=2
+  ad=0 pd=0 as=80 ps=48
M1015 a_150_n165# C0 VDD w_137_n171# CMOSP w=20 l=2
+  ad=120 pd=52 as=0 ps=0
M1016 a_n30_n423# A_3 gnd Gnd CMOSN w=40 l=2
+  ad=240 pd=92 as=0 ps=0
M1017 a_393_n93# a_243_n24# VDD w_380_n77# CMOSP w=20 l=2
+  ad=100 pd=50 as=0 ps=0
M1018 B_0 a_n172_n128# VDD w_n317_n154# CMOSP w=20 l=2
+  ad=145 pd=78 as=0 ps=0
M1019 S1 a_393_n93# gnd Gnd CMOSN w=10 l=2
+  ad=50 pd=30 as=0 ps=0
M1020 a_n101_n282# A_2 VDD w_n131_n354# CMOSP w=20 l=2
+  ad=100 pd=50 as=0 ps=0
M1021 a_n173_n336# a_n195_n304# VDD w_n318_n362# CMOSP w=20 l=2
+  ad=100 pd=50 as=0 ps=0
M1022 a_n282_n457# a_n304_n405# VDD w_n317_n463# CMOSP w=40 l=2
+  ad=160 pd=88 as=0 ps=0
M1023 a_n148_n96# a_n172_n128# gnd Gnd CMOSN w=20 l=2
+  ad=80 pd=48 as=0 ps=0
M1024 a_190_n165# a_174_n187# VDD w_137_n171# CMOSP w=20 l=2
+  ad=120 pd=52 as=0 ps=0
M1025 a_149_n338# a_146_n340# VDD w_143_n351# CMOSP w=20 l=2
+  ad=100 pd=50 as=0 ps=0
M1026 C1 a_75_n113# VDD w_38_n97# CMOSP w=20 l=2
+  ad=160 pd=78 as=0 ps=0
M1027 A_1 clk a_n238_n195# Gnd CMOSN w=20 l=2
+  ad=100 pd=50 as=80 ps=48
M1028 a_174_n296# a_150_n274# VDD w_137_n280# CMOSP w=20 l=2
+  ad=100 pd=50 as=0 ps=0
M1029 a_n30_n314# A_2 gnd Gnd CMOSN w=40 l=2
+  ad=240 pd=92 as=0 ps=0
M1030 a_44_n440# G2 a_51_n418# w_38_n424# CMOSP w=20 l=2
+  ad=100 pd=50 as=120 ps=52
M1031 A_0 a_n229_n49# VDD w_n295_n49# CMOSP w=20 l=2
+  ad=140 pd=76 as=0 ps=0
M1032 a_n217_n304# B2 gnd Gnd CMOSN w=10 l=2
+  ad=50 pd=30 as=0 ps=0
M1033 a_195_n452# Pout gnd Gnd CMOSN w=20 l=2
+  ad=200 pd=100 as=0 ps=0
M1034 gnd a_254_n361# a_250_n326# Gnd CMOSN w=20 l=2
+  ad=0 pd=0 as=80 ps=48
M1035 a_n101_n173# A_1 VDD w_n131_n245# CMOSP w=20 l=2
+  ad=100 pd=50 as=0 ps=0
M1036 A_3 a_n260_n437# VDD w_n317_n463# CMOSP w=20 l=2
+  ad=140 pd=76 as=0 ps=0
M1037 gnd Pt3 P32 Gnd CMOSN w=10 l=2
+  ad=0 pd=0 as=100 ps=60
M1038 a_44_n222# G0 a_51_n200# w_38_n206# CMOSP w=20 l=2
+  ad=100 pd=50 as=120 ps=52
M1039 a_231_n296# C3 VDD w_137_n280# CMOSP w=20 l=2
+  ad=100 pd=50 as=0 ps=0
M1040 a_n283_n356# a_n305_n304# VDD w_n318_n362# CMOSP w=40 l=2
+  ad=160 pd=88 as=0 ps=0
M1041 VDD G3 GPG3 w_38_n424# CMOSP w=20 l=2
+  ad=0 pd=0 as=120 ps=52
M1042 a_n282_n405# clk a_n282_n457# w_n317_n463# CMOSP w=40 l=2
+  ad=200 pd=90 as=0 ps=0
M1043 a_174_n187# a_150_n165# VDD w_137_n171# CMOSP w=20 l=2
+  ad=100 pd=50 as=0 ps=0
M1044 a_44_n331# G1 a_51_n309# w_38_n315# CMOSP w=20 l=2
+  ad=100 pd=50 as=120 ps=52
M1045 a_n238_n96# a_n260_n128# gnd Gnd CMOSN w=20 l=2
+  ad=80 pd=48 as=0 ps=0
M1046 a_n30_n96# A_0 gnd Gnd CMOSN w=40 l=2
+  ad=240 pd=92 as=0 ps=0
M1047 a_n172_n128# a_n194_n96# VDD w_n317_n154# CMOSP w=20 l=2
+  ad=100 pd=50 as=0 ps=0
M1048 a_n304_n195# A1 gnd Gnd CMOSN w=10 l=2
+  ad=50 pd=30 as=0 ps=0
M1049 a_n194_n195# a_n216_n195# gnd Gnd CMOSN w=10 l=2
+  ad=50 pd=30 as=0 ps=0
M1050 a_n30_n205# A_1 gnd Gnd CMOSN w=40 l=2
+  ad=240 pd=92 as=0 ps=0
M1051 a_n304_n96# clk a_n304_n148# w_n317_n154# CMOSP w=40 l=2
+  ad=200 pd=90 as=160 ps=88
M1052 VDD G1 GPG1 w_38_n206# CMOSP w=20 l=2
+  ad=0 pd=0 as=120 ps=52
M1053 gnd a_254_n252# a_250_n217# Gnd CMOSN w=20 l=2
+  ad=0 pd=0 as=80 ps=48
M1054 gnd Pt2 P21 Gnd CMOSN w=10 l=2
+  ad=0 pd=0 as=100 ps=60
M1055 gnd a_174_n296# a_183_n296# Gnd CMOSN w=10 l=2
+  ad=0 pd=0 as=100 ps=60
M1056 a_n148_n195# a_n172_n227# gnd Gnd CMOSN w=20 l=2
+  ad=80 pd=48 as=0 ps=0
M1057 a_250_n326# clk a_146_n340# Gnd CMOSN w=20 l=2
+  ad=0 pd=0 as=100 ps=50
M1058 a_393_n93# a_243_n24# gnd Gnd CMOSN w=10 l=2
+  ad=50 pd=30 as=0 ps=0
M1059 a_231_n187# C2 VDD w_137_n171# CMOSP w=20 l=2
+  ad=100 pd=50 as=0 ps=0
M1060 a_n260_n227# a_n282_n195# VDD w_n317_n253# CMOSP w=20 l=2
+  ad=100 pd=50 as=0 ps=0
M1061 VDD G2 GPG2 w_38_n315# CMOSP w=20 l=2
+  ad=0 pd=0 as=120 ps=52
M1062 a_n305_n304# clk a_n305_n356# w_n318_n362# CMOSP w=40 l=2
+  ad=200 pd=90 as=160 ps=88
M1063 a_n283_n304# clk a_n283_n356# w_n318_n362# CMOSP w=40 l=2
+  ad=200 pd=90 as=0 ps=0
M1064 a_n195_n304# clk a_n195_n356# w_n318_n362# CMOSP w=40 l=2
+  ad=200 pd=90 as=160 ps=88
M1065 a_n282_n96# a_n304_n96# gnd Gnd CMOSN w=10 l=2
+  ad=50 pd=30 as=0 ps=0
M1066 gnd a_254_n143# a_250_n108# Gnd CMOSN w=20 l=2
+  ad=0 pd=0 as=80 ps=48
M1067 a_150_n383# P32 a_150_n415# Gnd CMOSN w=20 l=2
+  ad=100 pd=50 as=120 ps=52
M1068 a_n282_n148# a_n304_n96# VDD w_n317_n154# CMOSP w=40 l=2
+  ad=160 pd=88 as=0 ps=0
M1069 gnd Pt1 P10 Gnd CMOSN w=10 l=2
+  ad=0 pd=0 as=100 ps=60
M1070 gnd a_174_n187# a_183_n187# Gnd CMOSN w=10 l=2
+  ad=0 pd=0 as=100 ps=60
M1071 a_174_n296# a_150_n274# gnd Gnd CMOSN w=10 l=2
+  ad=50 pd=30 as=0 ps=0
M1072 a_44_n440# G2 gnd Gnd CMOSN w=10 l=2
+  ad=100 pd=60 as=0 ps=0
M1073 a_n101_n64# A_0 VDD w_n131_n136# CMOSP w=20 l=2
+  ad=100 pd=50 as=0 ps=0
M1074 a_250_n217# clk a_146_n231# Gnd CMOSN w=20 l=2
+  ad=0 pd=0 as=100 ps=50
M1075 a_150_n165# P10 a_150_n197# Gnd CMOSN w=20 l=2
+  ad=100 pd=50 as=120 ps=52
M1076 a_174_n405# a_150_n383# gnd Gnd CMOSN w=10 l=2
+  ad=50 pd=30 as=0 ps=0
M1077 VDD a_278_n59# a_254_n59# w_243_n62# CMOSP w=20 l=2
+  ad=0 pd=0 as=100 ps=50
M1078 a_n172_n195# a_n194_n195# gnd Gnd CMOSN w=20 l=2
+  ad=80 pd=48 as=0 ps=0
M1079 a_150_n274# P21 a_150_n306# Gnd CMOSN w=20 l=2
+  ad=100 pd=50 as=120 ps=52
M1080 a_231_n296# C3 gnd Gnd CMOSN w=10 l=2
+  ad=70 pd=48 as=0 ps=0
M1081 a_274_n326# clk a_254_n361# Gnd CMOSN w=20 l=2
+  ad=80 pd=48 as=100 ps=50
M1082 VDD B_0 G0 w_n131_n136# CMOSP w=40 l=2
+  ad=0 pd=0 as=240 ps=92
M1083 C0 a_n260_n128# VDD w_n317_n154# CMOSP w=20 l=2
+  ad=145 pd=78 as=0 ps=0
M1084 a_250_n108# clk a_186_n112# Gnd CMOSN w=20 l=2
+  ad=0 pd=0 as=100 ps=50
M1085 a_174_n187# a_150_n165# gnd Gnd CMOSN w=10 l=2
+  ad=50 pd=30 as=0 ps=0
M1086 a_n282_n96# clk a_n282_n148# w_n317_n154# CMOSP w=40 l=2
+  ad=200 pd=90 as=0 ps=0
M1087 pgxor1 C1 s_1 w_123_n108# CMOSP w=8 l=2
+  ad=125 pd=80 as=80 ps=52
M1088 a_n216_n96# B0 gnd Gnd CMOSN w=10 l=2
+  ad=50 pd=30 as=0 ps=0
M1089 VDD a_254_n361# a_146_n340# w_243_n364# CMOSP w=20 l=2
+  ad=0 pd=0 as=100 ps=50
M1090 a_231_n187# C2 gnd Gnd CMOSN w=10 l=2
+  ad=70 pd=48 as=0 ps=0
M1091 a_274_n217# clk a_254_n252# Gnd CMOSN w=20 l=2
+  ad=80 pd=48 as=100 ps=50
M1092 a_195_n452# Pout a_195_n460# w_189_n473# CMOSP w=40 l=2
+  ad=200 pd=90 as=240 ps=92
M1093 a_152_n23# clk a_145_n23# Gnd CMOSN w=20 l=2
+  ad=80 pd=48 as=100 ps=50
M1094 VDD a_186_n112# a_189_n117# w_205_n123# CMOSP w=20 l=2
+  ad=0 pd=0 as=100 ps=50
M1095 a_n172_n227# clk a_n172_n195# Gnd CMOSN w=20 l=2
+  ad=100 pd=50 as=0 ps=0
M1096 a_136_n124# C1 VDD w_123_n108# CMOSP w=20 l=2
+  ad=100 pd=50 as=0 ps=0
M1097 a_n260_n96# a_n282_n96# gnd Gnd CMOSN w=20 l=2
+  ad=80 pd=48 as=0 ps=0
M1098 VDD a_254_n252# a_146_n231# w_137_n280# CMOSP w=20 l=2
+  ad=0 pd=0 as=100 ps=50
M1099 Gout GPG3 gnd Gnd CMOSN w=20 l=2
+  ad=200 pd=100 as=0 ps=0
M1100 Cout a_361_n386# VDD w_348_n370# CMOSP w=20 l=2
+  ad=100 pd=50 as=0 ps=0
M1101 a_51_n91# Pt0 VDD w_38_n97# CMOSP w=40 l=2
+  ad=240 pd=92 as=0 ps=0
M1102 a_274_n108# clk a_254_n143# Gnd CMOSN w=20 l=2
+  ad=80 pd=48 as=100 ps=50
M1103 a_n238_n195# a_n260_n227# gnd Gnd CMOSN w=20 l=2
+  ad=0 pd=0 as=0 ps=0
M1104 pgxor0 B_0 a_n101_n64# Gnd CMOSN w=4 l=2
+  ad=40 pd=36 as=70 ps=48
M1105 VDD G0 C1 w_38_n97# CMOSP w=20 l=2
+  ad=0 pd=0 as=0 ps=0
M1106 pgxor1 a_136_n124# s_1 Gnd CMOSN w=4 l=2
+  ad=69 pd=58 as=40 ps=36
M1107 VDD a_254_n143# a_186_n112# w_137_n171# CMOSP w=20 l=2
+  ad=0 pd=0 as=100 ps=50
M1108 a_n282_n43# A0 VDD w_n295_n49# CMOSP w=40 l=2
+  ad=160 pd=88 as=0 ps=0
M1109 a_n194_n457# a_n216_n405# VDD w_n317_n463# CMOSP w=40 l=2
+  ad=160 pd=88 as=0 ps=0
M1110 a_n304_n457# A3 VDD w_n317_n463# CMOSP w=40 l=2
+  ad=0 pd=0 as=0 ps=0
M1111 B_1 a_n172_n227# VDD w_n317_n253# CMOSP w=20 l=2
+  ad=145 pd=78 as=0 ps=0
M1112 gnd C4 a_300_n381# Gnd CMOSN w=10 l=2
+  ad=0 pd=0 as=50 ps=30
M1113 a_91_n341# a_75_n331# gnd Gnd CMOSN w=20 l=2
+  ad=120 pd=52 as=0 ps=0
M1114 VDD P32 a_150_n383# w_137_n389# CMOSP w=20 l=2
+  ad=0 pd=0 as=120 ps=52
M1115 C4 a_216_n386# a_257_n392# Gnd CMOSN w=20 l=2
+  ad=100 pd=50 as=120 ps=52
M1116 gnd a_180_n58# a_176_n23# Gnd CMOSN w=20 l=2
+  ad=0 pd=0 as=80 ps=48
M1117 a_136_n124# C1 gnd Gnd CMOSN w=10 l=2
+  ad=70 pd=48 as=0 ps=0
M1118 a_388_n16# a_145_n23# VDD w_375_0# CMOSP w=20 l=2
+  ad=100 pd=50 as=0 ps=0
M1119 a_n195_n356# a_n217_n304# VDD w_n318_n362# CMOSP w=40 l=2
+  ad=0 pd=0 as=0 ps=0
M1120 a_n194_n405# clk a_n194_n457# w_n317_n463# CMOSP w=40 l=2
+  ad=200 pd=90 as=0 ps=0
M1121 VDD s_1 a_318_n76# w_243_n62# CMOSP w=40 l=2
+  ad=0 pd=0 as=160 ps=88
M1122 a_91_n232# a_75_n222# gnd Gnd CMOSN w=20 l=2
+  ad=120 pd=52 as=0 ps=0
M1123 gnd s_3 a_300_n272# Gnd CMOSN w=10 l=2
+  ad=0 pd=0 as=50 ps=30
M1124 a_n305_n356# A2 VDD w_n318_n362# CMOSP w=40 l=2
+  ad=0 pd=0 as=0 ps=0
M1125 Cout a_361_n386# gnd Gnd CMOSN w=10 l=2
+  ad=50 pd=30 as=0 ps=0
M1126 a_n216_n405# clk a_n216_n457# w_n317_n463# CMOSP w=40 l=2
+  ad=200 pd=90 as=160 ps=88
M1127 pgxor0 B_0 A_0 w_n47_n53# CMOSP w=8 l=2
+  ad=0 pd=0 as=0 ps=0
M1128 a_n216_n195# B1 gnd Gnd CMOSN w=10 l=2
+  ad=50 pd=30 as=0 ps=0
M1129 VDD P21 a_150_n274# w_137_n280# CMOSP w=20 l=2
+  ad=0 pd=0 as=0 ps=0
M1130 gnd Pt0 a_44_n123# Gnd CMOSN w=20 l=2
+  ad=0 pd=0 as=200 ps=100
M1131 P32 Pt2 a_76_n374# w_38_n424# CMOSP w=20 l=2
+  ad=100 pd=50 as=120 ps=52
M1132 a_n282_n65# A0 gnd Gnd CMOSN w=10 l=2
+  ad=50 pd=30 as=0 ps=0
M1133 a_n172_n227# a_n194_n195# VDD w_n317_n253# CMOSP w=20 l=2
+  ad=100 pd=50 as=0 ps=0
M1134 a_183_n296# GPG2 a_190_n274# w_137_n280# CMOSP w=20 l=2
+  ad=100 pd=50 as=0 ps=0
M1135 gnd C0bar a_195_n452# Gnd CMOSN w=20 l=2
+  ad=0 pd=0 as=0 ps=0
M1136 VDD a_216_n386# C4 w_137_n389# CMOSP w=20 l=2
+  ad=0 pd=0 as=120 ps=52
M1137 VDD s_0 a_220_n75# w_123_n108# CMOSP w=40 l=2
+  ad=0 pd=0 as=160 ps=88
M1138 a_91_n123# a_75_n113# gnd Gnd CMOSN w=20 l=2
+  ad=120 pd=52 as=0 ps=0
M1139 gnd s_2 a_300_n163# Gnd CMOSN w=10 l=2
+  ad=0 pd=0 as=50 ps=30
M1140 VDD P10 a_150_n165# w_137_n171# CMOSP w=20 l=2
+  ad=0 pd=0 as=0 ps=0
M1141 a_n304_n195# clk a_n304_n247# w_n317_n253# CMOSP w=40 l=2
+  ad=200 pd=90 as=160 ps=88
M1142 a_n217_n304# clk a_n217_n356# w_n318_n362# CMOSP w=40 l=2
+  ad=200 pd=90 as=160 ps=88
M1143 gnd a_300_n381# a_278_n361# Gnd CMOSN w=10 l=2
+  ad=0 pd=0 as=50 ps=30
M1144 gnd a_278_n361# a_274_n326# Gnd CMOSN w=20 l=2
+  ad=0 pd=0 as=0 ps=0
M1145 a_n260_n43# a_n282_n65# VDD w_n295_n49# CMOSP w=40 l=2
+  ad=160 pd=88 as=0 ps=0
M1146 a_n194_n148# a_n216_n96# VDD w_n317_n154# CMOSP w=40 l=2
+  ad=160 pd=88 as=0 ps=0
M1147 P21 Pt1 a_76_n265# w_38_n315# CMOSP w=20 l=2
+  ad=100 pd=50 as=120 ps=52
M1148 a_n304_n148# Cin VDD w_n317_n154# CMOSP w=40 l=2
+  ad=0 pd=0 as=0 ps=0
M1149 a_183_n187# GPG1 a_190_n165# w_137_n171# CMOSP w=20 l=2
+  ad=100 pd=50 as=0 ps=0
M1150 a_n282_n247# a_n304_n195# VDD w_n317_n253# CMOSP w=40 l=2
+  ad=160 pd=88 as=0 ps=0
M1151 gnd a_278_n252# a_274_n217# Gnd CMOSN w=20 l=2
+  ad=0 pd=0 as=0 ps=0
M1152 C3 a_183_n296# VDD w_137_n280# CMOSP w=20 l=2
+  ad=140 pd=76 as=0 ps=0
M1153 gnd a_300_n272# a_278_n252# Gnd CMOSN w=10 l=2
+  ad=0 pd=0 as=50 ps=30
M1154 pgxor2 B_2 a_n101_n282# Gnd CMOSN w=4 l=2
+  ad=69 pd=58 as=70 ps=48
M1155 P10 Pt0 a_76_n156# w_38_n206# CMOSP w=20 l=2
+  ad=100 pd=50 as=120 ps=52
M1156 a_n194_n96# clk a_n194_n148# w_n317_n154# CMOSP w=40 l=2
+  ad=200 pd=90 as=0 ps=0
M1157 VDD a_300_n79# a_296_n76# w_243_n62# CMOSP w=40 l=2
+  ad=0 pd=0 as=0 ps=0
M1158 a_n216_n96# clk a_n216_n148# w_n317_n154# CMOSP w=40 l=2
+  ad=200 pd=90 as=160 ps=88
M1159 gnd a_278_n143# a_274_n108# Gnd CMOSN w=20 l=2
+  ad=0 pd=0 as=0 ps=0
M1160 C2 a_183_n187# VDD w_137_n171# CMOSP w=20 l=2
+  ad=140 pd=76 as=0 ps=0
M1161 A_1 a_n260_n227# VDD w_n317_n253# CMOSP w=20 l=2
+  ad=140 pd=76 as=0 ps=0
M1162 pgxor3 B_3 A_3 w_n47_n380# CMOSP w=8 l=2
+  ad=125 pd=80 as=0 ps=0
M1163 A_0 clk a_n205_n17# Gnd CMOSN w=20 l=2
+  ad=120 pd=52 as=80 ps=48
M1164 VDD a_180_n58# a_156_n58# w_123_n108# CMOSP w=20 l=2
+  ad=0 pd=0 as=100 ps=50
M1165 gnd a_300_n163# a_278_n143# Gnd CMOSN w=10 l=2
+  ad=0 pd=0 as=50 ps=30
M1166 pgxor1 B_1 a_n101_n173# Gnd CMOSN w=4 l=2
+  ad=0 pd=0 as=70 ps=48
M1167 a_n282_n195# clk a_n282_n247# w_n317_n253# CMOSP w=40 l=2
+  ad=200 pd=90 as=0 ps=0
M1168 a_183_n296# GPG2 gnd Gnd CMOSN w=10 l=2
+  ad=0 pd=0 as=0 ps=0
M1169 Gout GPG3 a_198_n403# w_137_n389# CMOSP w=40 l=2
+  ad=200 pd=90 as=240 ps=92
M1170 a_44_n123# C0bar a_51_n91# w_38_n97# CMOSP w=40 l=2
+  ad=200 pd=90 as=0 ps=0
M1171 C0 a_84_n59# s_0 Gnd CMOSN w=4 l=2
+  ad=129 pd=72 as=40 ps=36
M1172 pgxor2 a_231_n187# s_2 Gnd CMOSN w=4 l=2
+  ad=0 pd=0 as=40 ps=36
M1173 S3 a_368_n263# VDD w_355_n247# CMOSP w=20 l=2
+  ad=100 pd=50 as=0 ps=0
M1174 a_n260_n65# a_n282_n65# gnd Gnd CMOSN w=10 l=2
+  ad=50 pd=30 as=0 ps=0
M1175 VDD a_202_n78# a_198_n75# w_123_n108# CMOSP w=40 l=2
+  ad=0 pd=0 as=0 ps=0
M1176 G0 A_0 VDD w_n131_n136# CMOSP w=40 l=2
+  ad=0 pd=0 as=0 ps=0
M1177 a_183_n187# GPG1 gnd Gnd CMOSN w=10 l=2
+  ad=0 pd=0 as=0 ps=0
M1178 pgxor2 B_2 A_2 w_n47_n271# CMOSP w=8 l=2
+  ad=125 pd=80 as=140 ps=76
M1179 VDD a_243_n24# a_333_n98# w_243_n62# CMOSP w=20 l=2
+  ad=0 pd=0 as=100 ps=50
M1180 pgxor3 C3 s_3 w_137_n280# CMOSP w=8 l=2
+  ad=0 pd=0 as=80 ps=52
M1181 a_216_n386# a_195_n452# gnd Gnd CMOSN w=10 l=2
+  ad=50 pd=30 as=0 ps=0
M1182 C3 a_183_n296# gnd Gnd CMOSN w=10 l=2
+  ad=50 pd=30 as=0 ps=0
M1183 a_216_n386# a_195_n452# VDD w_189_n473# CMOSP w=20 l=2
+  ad=100 pd=50 as=0 ps=0
M1184 a_91_n450# a_75_n440# gnd Gnd CMOSN w=20 l=2
+  ad=120 pd=52 as=0 ps=0
M1185 a_n282_n405# a_n304_n405# gnd Gnd CMOSN w=10 l=2
+  ad=50 pd=30 as=0 ps=0
M1186 a_195_n460# C0bar VDD w_189_n473# CMOSP w=40 l=2
+  ad=0 pd=0 as=0 ps=0
M1187 VDD A_3 a_n125_n450# w_n131_n463# CMOSP w=80 l=2
+  ad=0 pd=0 as=480 ps=172
M1188 VDD a_278_n361# a_254_n361# w_243_n364# CMOSP w=20 l=2
+  ad=0 pd=0 as=100 ps=50
M1189 a_n260_n128# clk a_n260_n96# Gnd CMOSN w=20 l=2
+  ad=100 pd=50 as=0 ps=0
M1190 C0 pgxor0 s_0 w_38_n97# CMOSP w=8 l=2
+  ad=0 pd=0 as=0 ps=0
M1191 gnd a_186_n112# a_189_n117# Gnd CMOSN w=10 l=2
+  ad=0 pd=0 as=50 ps=30
M1192 pgxor1 B_1 A_1 w_n47_n162# CMOSP w=8 l=2
+  ad=0 pd=0 as=0 ps=0
M1193 a_361_n386# a_146_n340# VDD w_348_n370# CMOSP w=20 l=2
+  ad=100 pd=50 as=0 ps=0
M1194 pgxor2 C2 s_2 w_137_n171# CMOSP w=8 l=2
+  ad=0 pd=0 as=80 ps=52
M1195 a_n216_n457# B3 VDD w_n317_n463# CMOSP w=40 l=2
+  ad=0 pd=0 as=0 ps=0
M1196 VDD B_3 G3 w_n131_n463# CMOSP w=40 l=2
+  ad=0 pd=0 as=240 ps=92
M1197 C0bar C0 VDD w_n131_n136# CMOSP w=20 l=2
+  ad=100 pd=50 as=0 ps=0
M1198 C2 a_183_n187# gnd Gnd CMOSN w=10 l=2
+  ad=50 pd=30 as=0 ps=0
M1199 VDD A_2 a_n125_n341# w_n131_n354# CMOSP w=80 l=2
+  ad=0 pd=0 as=480 ps=172
M1200 gnd a_174_n405# Gout Gnd CMOSN w=20 l=2
+  ad=0 pd=0 as=0 ps=0
M1201 a_n282_n65# clk a_n282_n43# w_n295_n49# CMOSP w=40 l=2
+  ad=200 pd=90 as=0 ps=0
M1202 a_274_n24# clk a_254_n59# Gnd CMOSN w=20 l=2
+  ad=0 pd=0 as=100 ps=50
M1203 VDD a_278_n252# a_254_n252# w_137_n280# CMOSP w=20 l=2
+  ad=0 pd=0 as=100 ps=50
M1204 a_n283_n304# a_n305_n304# gnd Gnd CMOSN w=10 l=2
+  ad=50 pd=30 as=0 ps=0
M1205 a_n229_n17# a_n260_n65# gnd Gnd CMOSN w=20 l=2
+  ad=80 pd=48 as=0 ps=0
M1206 s_1 pgxor1 a_136_n124# Gnd CMOSN w=4 l=2
+  ad=0 pd=0 as=0 ps=0
M1207 VDD B_1 G1 w_n131_n245# CMOSP w=40 l=2
+  ad=0 pd=0 as=240 ps=92
M1208 S3 a_368_n263# gnd Gnd CMOSN w=10 l=2
+  ad=50 pd=30 as=0 ps=0
M1209 Pt3 A_3 gnd Gnd CMOSN w=40 l=2
+  ad=400 pd=180 as=0 ps=0
M1210 a_n194_n96# a_n216_n96# gnd Gnd CMOSN w=10 l=2
+  ad=50 pd=30 as=0 ps=0
M1211 a_n149_n304# a_n173_n336# gnd Gnd CMOSN w=20 l=2
+  ad=80 pd=48 as=0 ps=0
M1212 VDD B_2 G2 w_n131_n354# CMOSP w=40 l=2
+  ad=0 pd=0 as=240 ps=92
M1213 B_0 clk a_n148_n96# Gnd CMOSN w=20 l=2
+  ad=129 pd=72 as=0 ps=0
M1214 a_n217_n356# B2 VDD w_n318_n362# CMOSP w=40 l=2
+  ad=0 pd=0 as=0 ps=0
M1215 B_3 clk a_n148_n405# Gnd CMOSN w=20 l=2
+  ad=129 pd=72 as=80 ps=48
M1216 gnd a_243_n24# a_333_n98# Gnd CMOSN w=10 l=2
+  ad=0 pd=0 as=50 ps=30
M1217 VDD a_145_n23# a_153_n133# w_137_n171# CMOSP w=20 l=2
+  ad=0 pd=0 as=100 ps=50
M1218 gnd a_145_n23# a_153_n133# Gnd CMOSN w=10 l=2
+  ad=0 pd=0 as=50 ps=30
M1219 VDD A_1 a_n125_n232# w_n131_n245# CMOSP w=80 l=2
+  ad=0 pd=0 as=480 ps=172
M1220 a_149_n229# a_146_n231# gnd Gnd CMOSN w=10 l=2
+  ad=50 pd=30 as=0 ps=0
M1221 gnd Pt2 a_44_n331# Gnd CMOSN w=10 l=2
+  ad=0 pd=0 as=100 ps=60
M1222 a_176_n23# clk a_156_n58# Gnd CMOSN w=20 l=2
+  ad=0 pd=0 as=100 ps=50
M1223 VDD a_278_n143# a_254_n143# w_137_n171# CMOSP w=20 l=2
+  ad=0 pd=0 as=100 ps=50
M1224 gnd P10 a_156_n444# Gnd CMOSN w=20 l=2
+  ad=0 pd=0 as=120 ps=52
M1225 a_n260_n405# a_n282_n405# gnd Gnd CMOSN w=20 l=2
+  ad=80 pd=48 as=0 ps=0
M1226 Pt2 A_2 gnd Gnd CMOSN w=40 l=2
+  ad=400 pd=180 as=0 ps=0
M1227 a_318_n76# clk a_300_n79# w_243_n62# CMOSP w=40 l=2
+  ad=0 pd=0 as=200 ps=90
M1228 a_296_n378# clk a_278_n361# w_243_n364# CMOSP w=40 l=2
+  ad=160 pd=88 as=200 ps=90
M1229 gnd Pt1 a_44_n222# Gnd CMOSN w=10 l=2
+  ad=0 pd=0 as=0 ps=0
M1230 B_2 clk a_n149_n304# Gnd CMOSN w=20 l=2
+  ad=129 pd=72 as=0 ps=0
M1231 a_257_n392# Gout gnd Gnd CMOSN w=20 l=2
+  ad=0 pd=0 as=0 ps=0
M1232 VDD A_0 a_n125_n123# w_n131_n136# CMOSP w=80 l=2
+  ad=0 pd=0 as=480 ps=172
M1233 a_361_n386# a_146_n340# gnd Gnd CMOSN w=10 l=2
+  ad=50 pd=30 as=0 ps=0
M1234 pgxor3 B_3 a_n101_n391# Gnd CMOSN w=4 l=2
+  ad=69 pd=58 as=70 ps=48
M1235 C0 clk a_n238_n96# Gnd CMOSN w=20 l=2
+  ad=0 pd=0 as=0 ps=0
M1236 C0bar C0 gnd Gnd CMOSN w=10 l=2
+  ad=50 pd=30 as=0 ps=0
M1237 Pt1 A_1 gnd Gnd CMOSN w=40 l=2
+  ad=400 pd=180 as=0 ps=0
M1238 a_n261_n304# a_n283_n304# gnd Gnd CMOSN w=20 l=2
+  ad=80 pd=48 as=0 ps=0
M1239 a_n260_n437# clk a_n260_n405# Gnd CMOSN w=20 l=2
+  ad=100 pd=50 as=0 ps=0
M1240 gnd a_254_n59# a_250_n24# Gnd CMOSN w=20 l=2
+  ad=0 pd=0 as=80 ps=48
M1241 a_220_n75# clk a_202_n78# w_123_n108# CMOSP w=40 l=2
+  ad=0 pd=0 as=200 ps=90
M1242 a_n216_n148# B0 VDD w_n317_n154# CMOSP w=40 l=2
+  ad=0 pd=0 as=0 ps=0
M1243 a_296_n269# clk a_278_n252# w_137_n280# CMOSP w=40 l=2
+  ad=160 pd=88 as=200 ps=90
M1244 a_75_n331# a_44_n331# gnd Gnd CMOSN w=10 l=2
+  ad=50 pd=30 as=0 ps=0
M1245 VDD P10 Pout w_38_n424# CMOSP w=20 l=2
+  ad=0 pd=0 as=120 ps=52
M1246 GPG2 G2 a_91_n341# Gnd CMOSN w=20 l=2
+  ad=100 pd=50 as=0 ps=0
M1247 a_n260_n65# clk a_n260_n43# w_n295_n49# CMOSP w=40 l=2
+  ad=200 pd=90 as=0 ps=0
M1248 a_n194_n247# a_n216_n195# VDD w_n317_n253# CMOSP w=40 l=2
+  ad=160 pd=88 as=0 ps=0
M1249 a_76_n374# Pt3 VDD w_38_n424# CMOSP w=20 l=2
+  ad=0 pd=0 as=0 ps=0
M1250 Pt0 A_0 gnd Gnd CMOSN w=40 l=2
+  ad=0 pd=0 as=0 ps=0
M1251 a_n304_n247# A1 VDD w_n317_n253# CMOSP w=40 l=2
+  ad=0 pd=0 as=0 ps=0
M1252 pgxor3 a_231_n296# s_3 Gnd CMOSN w=4 l=2
+  ad=0 pd=0 as=40 ps=36
M1253 C4 Gout VDD w_137_n389# CMOSP w=20 l=2
+  ad=0 pd=0 as=0 ps=0
M1254 gnd a_156_n58# a_152_n23# Gnd CMOSN w=20 l=2
+  ad=0 pd=0 as=0 ps=0
M1255 a_n172_n96# a_n194_n96# gnd Gnd CMOSN w=20 l=2
+  ad=80 pd=48 as=0 ps=0
M1256 a_388_n16# a_145_n23# gnd Gnd CMOSN w=10 l=2
+  ad=50 pd=30 as=0 ps=0
M1257 a_n101_n64# A_0 gnd Gnd CMOSN w=10 l=2
+  ad=0 pd=0 as=0 ps=0
M1258 a_296_n160# clk a_278_n143# w_137_n171# CMOSP w=40 l=2
+  ad=0 pd=0 as=200 ps=90
M1259 a_75_n222# a_44_n222# gnd Gnd CMOSN w=10 l=2
+  ad=50 pd=30 as=0 ps=0
M1260 a_n261_n336# clk a_n261_n304# Gnd CMOSN w=20 l=2
+  ad=100 pd=50 as=0 ps=0
M1261 GPG1 G1 a_91_n232# Gnd CMOSN w=20 l=2
+  ad=100 pd=50 as=0 ps=0
M1262 a_51_n418# Pt3 VDD w_38_n424# CMOSP w=20 l=2
+  ad=0 pd=0 as=0 ps=0
M1263 a_n229_n49# a_n260_n65# VDD w_n295_n49# CMOSP w=20 l=2
+  ad=100 pd=50 as=0 ps=0
M1264 a_44_n123# C0bar gnd Gnd CMOSN w=20 l=2
+  ad=0 pd=0 as=0 ps=0
M1265 a_76_n265# Pt2 VDD w_38_n315# CMOSP w=20 l=2
+  ad=0 pd=0 as=0 ps=0
M1266 a_n216_n195# clk a_n216_n247# w_n317_n253# CMOSP w=40 l=2
+  ad=200 pd=90 as=160 ps=88
M1267 a_n194_n195# clk a_n194_n247# w_n317_n253# CMOSP w=40 l=2
+  ad=200 pd=90 as=0 ps=0
M1268 B_2 a_n101_n282# pgxor2 Gnd CMOSN w=4 l=2
+  ad=0 pd=0 as=0 ps=0
M1269 B_2 a_n173_n336# VDD w_n318_n362# CMOSP w=20 l=2
+  ad=145 pd=78 as=0 ps=0
M1270 a_51_n200# Pt1 VDD w_38_n206# CMOSP w=20 l=2
+  ad=0 pd=0 as=0 ps=0
M1271 G3 B_3 a_n30_n423# Gnd CMOSN w=40 l=2
+  ad=200 pd=90 as=0 ps=0
M1272 a_75_n113# a_44_n123# gnd Gnd CMOSN w=10 l=2
+  ad=50 pd=30 as=0 ps=0
M1273 a_n239_n304# a_n261_n336# gnd Gnd CMOSN w=20 l=2
+  ad=80 pd=48 as=0 ps=0
M1274 GPG3 a_75_n440# VDD w_38_n424# CMOSP w=20 l=2
+  ad=0 pd=0 as=0 ps=0
M1275 A_3 clk a_n238_n405# Gnd CMOSN w=20 l=2
+  ad=100 pd=50 as=80 ps=48
M1276 C1 G0 a_91_n123# Gnd CMOSN w=20 l=2
+  ad=100 pd=50 as=0 ps=0
M1277 a_76_n156# Pt1 VDD w_38_n206# CMOSP w=20 l=2
+  ad=0 pd=0 as=0 ps=0
M1278 S2 a_365_n157# VDD w_352_n141# CMOSP w=20 l=2
+  ad=100 pd=50 as=0 ps=0
M1279 a_51_n309# Pt2 VDD w_38_n315# CMOSP w=20 l=2
+  ad=0 pd=0 as=0 ps=0
M1280 a_n260_n437# a_n282_n405# VDD w_n317_n463# CMOSP w=20 l=2
+  ad=100 pd=50 as=0 ps=0
M1281 G1 B_1 a_n30_n205# Gnd CMOSN w=40 l=2
+  ad=200 pd=90 as=0 ps=0
M1282 B_3 A_3 pgxor3 w_n47_n380# CMOSP w=8 l=2
+  ad=145 pd=78 as=0 ps=0
M1283 B_1 a_n101_n173# pgxor1 Gnd CMOSN w=4 l=2
+  ad=129 pd=72 as=0 ps=0
M1284 GPG1 a_75_n222# VDD w_38_n206# CMOSP w=20 l=2
+  ad=0 pd=0 as=0 ps=0
M1285 G2 B_2 a_n30_n314# Gnd CMOSN w=40 l=2
+  ad=200 pd=90 as=0 ps=0
M1286 s_2 pgxor2 a_231_n187# Gnd CMOSN w=4 l=2
+  ad=0 pd=0 as=0 ps=0
M1287 a_368_n263# a_146_n231# VDD w_355_n247# CMOSP w=20 l=2
+  ad=100 pd=50 as=0 ps=0
M1288 GPG2 a_75_n331# VDD w_38_n315# CMOSP w=20 l=2
+  ad=0 pd=0 as=0 ps=0
M1289 a_75_n440# a_44_n440# VDD w_38_n424# CMOSP w=20 l=2
+  ad=100 pd=50 as=0 ps=0
M1290 a_n194_n405# a_n216_n405# gnd Gnd CMOSN w=10 l=2
+  ad=50 pd=30 as=0 ps=0
M1291 a_198_n403# a_174_n405# VDD w_137_n389# CMOSP w=40 l=2
+  ad=0 pd=0 as=0 ps=0
M1292 a_n304_n405# A3 gnd Gnd CMOSN w=10 l=2
+  ad=50 pd=30 as=0 ps=0
M1293 P32 Pt2 gnd Gnd CMOSN w=10 l=2
+  ad=0 pd=0 as=0 ps=0
M1294 a_n304_n96# Cin gnd Gnd CMOSN w=10 l=2
+  ad=50 pd=30 as=0 ps=0
M1295 s_1 pgxor1 C1 w_123_n108# CMOSP w=8 l=2
+  ad=0 pd=0 as=0 ps=0
M1296 a_365_n157# a_186_n112# VDD w_352_n141# CMOSP w=20 l=2
+  ad=100 pd=50 as=0 ps=0
M1297 A_2 clk a_n239_n304# Gnd CMOSN w=20 l=2
+  ad=100 pd=50 as=0 ps=0
M1298 VDD a_254_n59# a_243_n24# w_243_n62# CMOSP w=20 l=2
+  ad=0 pd=0 as=100 ps=50
M1299 B_2 A_2 pgxor2 w_n47_n271# CMOSP w=8 l=2
+  ad=0 pd=0 as=0 ps=0
M1300 a_n261_n336# a_n283_n304# VDD w_n318_n362# CMOSP w=20 l=2
+  ad=100 pd=50 as=0 ps=0
M1301 a_150_n415# GPG1 gnd Gnd CMOSN w=20 l=2
+  ad=0 pd=0 as=0 ps=0
M1302 a_n148_n405# a_n172_n437# gnd Gnd CMOSN w=20 l=2
+  ad=0 pd=0 as=0 ps=0
M1303 S0 a_388_n16# VDD w_375_0# CMOSP w=20 l=2
+  ad=100 pd=50 as=0 ps=0
M1304 G0 B_0 a_n30_n96# Gnd CMOSN w=40 l=2
+  ad=200 pd=90 as=0 ps=0
M1305 a_75_n222# a_44_n222# VDD w_38_n206# CMOSP w=20 l=2
+  ad=100 pd=50 as=0 ps=0
M1306 s_3 pgxor3 C3 w_137_n280# CMOSP w=8 l=2
+  ad=0 pd=0 as=0 ps=0
M1307 gnd Pt3 a_44_n440# Gnd CMOSN w=10 l=2
+  ad=0 pd=0 as=0 ps=0
M1308 a_149_n338# a_146_n340# gnd Gnd CMOSN w=10 l=2
+  ad=50 pd=30 as=0 ps=0
M1309 P21 Pt1 gnd Gnd CMOSN w=10 l=2
+  ad=0 pd=0 as=0 ps=0
M1310 a_75_n331# a_44_n331# VDD w_38_n315# CMOSP w=20 l=2
+  ad=100 pd=50 as=0 ps=0
M1311 a_150_n197# C0 gnd Gnd CMOSN w=20 l=2
+  ad=0 pd=0 as=0 ps=0
M1312 a_n195_n304# a_n217_n304# gnd Gnd CMOSN w=10 l=2
+  ad=50 pd=30 as=0 ps=0
M1313 gnd s_1 a_300_n79# Gnd CMOSN w=10 l=2
+  ad=0 pd=0 as=50 ps=30
M1314 a_n305_n304# A2 gnd Gnd CMOSN w=10 l=2
+  ad=50 pd=30 as=0 ps=0
M1315 a_150_n306# C1 gnd Gnd CMOSN w=20 l=2
+  ad=0 pd=0 as=0 ps=0
M1316 VDD a_156_n58# a_145_n23# w_123_n108# CMOSP w=20 l=2
+  ad=0 pd=0 as=100 ps=50
M1317 B_1 A_1 pgxor1 w_n47_n162# CMOSP w=8 l=2
+  ad=0 pd=0 as=0 ps=0
M1318 a_n125_n450# B_3 Pt3 w_n131_n463# CMOSP w=80 l=2
+  ad=0 pd=0 as=400 ps=170
M1319 VDD C4 a_318_n378# w_243_n364# CMOSP w=40 l=2
+  ad=0 pd=0 as=160 ps=88
M1320 s_2 pgxor2 C2 w_137_n171# CMOSP w=8 l=2
+  ad=0 pd=0 as=0 ps=0
M1321 S2 a_365_n157# gnd Gnd CMOSN w=10 l=2
+  ad=50 pd=30 as=0 ps=0
M1322 a_n229_n49# clk a_n229_n17# Gnd CMOSN w=20 l=2
+  ad=120 pd=52 as=0 ps=0
M1323 P10 Pt0 gnd Gnd CMOSN w=10 l=2
+  ad=0 pd=0 as=0 ps=0
M1324 a_n101_n391# A_3 gnd Gnd CMOSN w=10 l=2
+  ad=0 pd=0 as=0 ps=0
M1325 a_n260_n128# a_n282_n96# VDD w_n317_n154# CMOSP w=20 l=2
+  ad=100 pd=50 as=0 ps=0
M1326 a_n282_n195# a_n304_n195# gnd Gnd CMOSN w=10 l=2
+  ad=50 pd=30 as=0 ps=0
M1327 a_149_n229# a_146_n231# VDD w_143_n242# CMOSP w=20 l=2
+  ad=100 pd=50 as=0 ps=0
M1328 G3 A_3 VDD w_n131_n463# CMOSP w=40 l=2
+  ad=0 pd=0 as=0 ps=0
M1329 a_n172_n405# a_n194_n405# gnd Gnd CMOSN w=20 l=2
+  ad=80 pd=48 as=0 ps=0
M1330 gnd s_0 a_202_n78# Gnd CMOSN w=10 l=2
+  ad=0 pd=0 as=50 ps=30
M1331 B_0 a_n101_n64# pgxor0 Gnd CMOSN w=4 l=2
+  ad=0 pd=0 as=0 ps=0
M1332 a_368_n263# a_146_n231# gnd Gnd CMOSN w=10 l=2
+  ad=50 pd=30 as=0 ps=0
M1333 a_75_n440# a_44_n440# gnd Gnd CMOSN w=10 l=2
+  ad=50 pd=30 as=0 ps=0
M1334 a_84_n59# pgxor0 VDD w_38_n97# CMOSP w=20 l=2
+  ad=100 pd=50 as=0 ps=0
M1335 S0 a_388_n16# gnd Gnd CMOSN w=10 l=2
+  ad=50 pd=30 as=0 ps=0
M1336 VDD s_3 a_318_n269# w_137_n280# CMOSP w=40 l=2
+  ad=0 pd=0 as=160 ps=88
M1337 GPG3 G3 a_91_n450# Gnd CMOSN w=20 l=2
+  ad=100 pd=50 as=0 ps=0
M1338 a_n125_n341# B_2 Pt2 w_n131_n354# CMOSP w=80 l=2
+  ad=0 pd=0 as=400 ps=170
M1339 a_365_n157# a_186_n112# gnd Gnd CMOSN w=10 l=2
+  ad=50 pd=30 as=0 ps=0
M1340 A_2 a_n261_n336# VDD w_n318_n362# CMOSP w=20 l=2
+  ad=0 pd=0 as=0 ps=0
M1341 gnd B_3 Pt3 Gnd CMOSN w=40 l=2
+  ad=0 pd=0 as=0 ps=0
M1342 a_318_n378# clk a_300_n381# w_243_n364# CMOSP w=40 l=2
+  ad=0 pd=0 as=200 ps=90
M1343 a_n101_n282# A_2 gnd Gnd CMOSN w=10 l=2
+  ad=0 pd=0 as=0 ps=0
M1344 G2 A_2 VDD w_n131_n354# CMOSP w=40 l=2
+  ad=0 pd=0 as=0 ps=0
M1345 a_75_n113# a_44_n123# VDD w_38_n97# CMOSP w=20 l=2
+  ad=100 pd=50 as=0 ps=0
M1346 a_n125_n232# B_1 Pt1 w_n131_n245# CMOSP w=80 l=2
+  ad=0 pd=0 as=400 ps=170
M1347 a_n173_n304# a_n195_n304# gnd Gnd CMOSN w=20 l=2
+  ad=80 pd=48 as=0 ps=0
M1348 a_n172_n437# clk a_n172_n405# Gnd CMOSN w=20 l=2
+  ad=100 pd=50 as=0 ps=0
M1349 VDD s_2 a_318_n160# w_137_n171# CMOSP w=40 l=2
+  ad=0 pd=0 as=160 ps=88
M1350 a_156_n444# P32 Pout Gnd CMOSN w=20 l=2
+  ad=0 pd=0 as=100 ps=50
M1351 B_1 clk a_n148_n195# Gnd CMOSN w=20 l=2
+  ad=0 pd=0 as=0 ps=0
M1352 a_318_n269# clk a_300_n272# w_137_n280# CMOSP w=40 l=2
+  ad=0 pd=0 as=200 ps=90
M1353 VDD a_300_n381# a_296_n378# w_243_n364# CMOSP w=40 l=2
+  ad=0 pd=0 as=0 ps=0
M1354 gnd B_2 Pt2 Gnd CMOSN w=40 l=2
+  ad=0 pd=0 as=0 ps=0
M1355 a_n101_n173# A_1 gnd Gnd CMOSN w=10 l=2
+  ad=0 pd=0 as=0 ps=0
M1356 G1 A_1 VDD w_n131_n245# CMOSP w=40 l=2
+  ad=0 pd=0 as=0 ps=0
M1357 B_3 a_n101_n391# pgxor3 Gnd CMOSN w=4 l=2
+  ad=0 pd=0 as=0 ps=0
M1358 a_n205_n17# a_n229_n49# gnd Gnd CMOSN w=20 l=2
+  ad=0 pd=0 as=0 ps=0
M1359 a_250_n24# clk a_243_n24# Gnd CMOSN w=20 l=2
+  ad=0 pd=0 as=100 ps=50
M1360 gnd a_300_n79# a_278_n59# Gnd CMOSN w=10 l=2
+  ad=0 pd=0 as=50 ps=30
M1361 B_0 A_0 pgxor0 w_n47_n53# CMOSP w=8 l=2
+  ad=0 pd=0 as=0 ps=0
M1362 a_n216_n247# B1 VDD w_n317_n253# CMOSP w=40 l=2
+  ad=0 pd=0 as=0 ps=0
M1363 B_3 a_n172_n437# VDD w_n317_n463# CMOSP w=20 l=2
+  ad=0 pd=0 as=0 ps=0
M1364 a_n125_n123# B_0 Pt0 w_n131_n136# CMOSP w=80 l=2
+  ad=0 pd=0 as=400 ps=170
M1365 a_n260_n195# a_n282_n195# gnd Gnd CMOSN w=20 l=2
+  ad=0 pd=0 as=0 ps=0
M1366 a_n238_n405# a_n260_n437# gnd Gnd CMOSN w=20 l=2
+  ad=0 pd=0 as=0 ps=0
M1367 a_n173_n336# clk a_n173_n304# Gnd CMOSN w=20 l=2
+  ad=100 pd=50 as=0 ps=0
M1368 a_44_n331# G1 gnd Gnd CMOSN w=10 l=2
+  ad=0 pd=0 as=0 ps=0
M1369 a_84_n59# pgxor0 gnd Gnd CMOSN w=10 l=2
+  ad=70 pd=48 as=0 ps=0
M1370 S1 a_393_n93# VDD w_380_n77# CMOSP w=20 l=2
+  ad=100 pd=50 as=0 ps=0
M1371 a_318_n160# clk a_300_n163# w_137_n171# CMOSP w=40 l=2
+  ad=0 pd=0 as=200 ps=90
M1372 gnd B_1 Pt1 Gnd CMOSN w=40 l=2
+  ad=0 pd=0 as=0 ps=0
M1373 VDD a_300_n272# a_296_n269# w_137_n280# CMOSP w=40 l=2
+  ad=0 pd=0 as=0 ps=0
M1374 a_150_n383# GPG1 VDD w_137_n389# CMOSP w=20 l=2
+  ad=0 pd=0 as=0 ps=0
M1375 a_n172_n128# clk a_n172_n96# Gnd CMOSN w=20 l=2
+  ad=100 pd=50 as=0 ps=0
M1376 s_0 C0 a_84_n59# Gnd CMOSN w=4 l=2
+  ad=0 pd=0 as=0 ps=0
M1377 Pout P32 VDD w_38_n424# CMOSP w=20 l=2
+  ad=0 pd=0 as=0 ps=0
M1378 gnd a_202_n78# a_180_n58# Gnd CMOSN w=10 l=2
+  ad=0 pd=0 as=50 ps=30
M1379 s_3 pgxor3 a_231_n296# Gnd CMOSN w=4 l=2
+  ad=0 pd=0 as=0 ps=0
C0 clk a_254_n252# 0.09fF
C1 a_n260_n227# VDD 0.08fF
C2 a_44_n440# VDD 0.08fF
C3 a_n194_n405# gnd 0.06fF
C4 clk a_278_n361# 0.33fF
C5 w_n318_n362# VDD 0.17fF
C6 w_n317_n154# a_n216_n96# 0.09fF
C7 a_254_n143# gnd 0.08fF
C8 B_3 a_n101_n391# 0.20fF
C9 a_44_n331# gnd 0.12fF
C10 a_51_n309# VDD 0.01fF
C11 a_254_n252# gnd 0.08fF
C12 w_n47_n271# A_2 0.19fF
C13 w_137_n280# P21 0.06fF
C14 w_n131_n354# B_2 0.57fF
C15 w_123_n108# C1 0.40fF
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
