VedantPahariya/VLSI-Carry-Look-Ahead-Adder/Magic/Finals/complete.cir

.include TSMC_180nm.txt
.param SUPPLY=1.8
.global gnd vdd

* Supply
Vdd vdd gnd 'SUPPLY'

* SPICE3 file created from complete.ext - technology: scmos

.option scale=0.09u

M1000 a_296_n76# clk a_278_n59# w_243_n62# CMOSP w=40 l=2
+  ad=160 pd=88 as=200 ps=90
M1001 gnd B_0 Pt0 Gnd CMOSN w=40 l=2
+  ad=6205 pd=3112 as=400 ps=180
M1002 VDD a_300_n163# a_296_n160# w_137_n171# CMOSP w=40 l=2
+  ad=11800 pd=5570 as=160 ps=88
M1003 a_44_n222# G0 gnd Gnd CMOSN w=10 l=2
+  ad=100 pd=60 as=0 ps=0
M1004 a_150_n274# C1 VDD w_137_n280# CMOSP w=20 l=2
+  ad=120 pd=52 as=0 ps=0
M1005 a_n101_n391# A_3 VDD w_n131_n463# CMOSP w=20 l=2
+  ad=100 pd=50 as=0 ps=0
M1006 a_198_n75# clk a_180_n58# w_123_n108# CMOSP w=40 l=2
+  ad=160 pd=88 as=200 ps=90
M1007 a_190_n274# a_174_n296# VDD w_137_n280# CMOSP w=20 l=2
+  ad=120 pd=52 as=0 ps=0
M1008 a_174_n405# a_150_n383# VDD w_137_n389# CMOSP w=20 l=2
+  ad=100 pd=50 as=0 ps=0
M1009 s_0 C0 pgxor0 w_38_n97# CMOSP w=8 l=2
+  ad=80 pd=52 as=120 ps=78
M1010 gnd a_278_n59# a_274_n24# Gnd CMOSN w=20 l=2
+  ad=0 pd=0 as=80 ps=48
M1011 a_150_n165# C0 VDD w_137_n171# CMOSP w=20 l=2
+  ad=120 pd=52 as=0 ps=0
M1012 a_n30_n423# A_3 gnd Gnd CMOSN w=40 l=2
+  ad=240 pd=92 as=0 ps=0
M1013 a_n101_n282# A_2 VDD w_n131_n354# CMOSP w=20 l=2
+  ad=100 pd=50 as=0 ps=0
M1014 a_190_n165# a_174_n187# VDD w_137_n171# CMOSP w=20 l=2
+  ad=120 pd=52 as=0 ps=0
M1015 a_149_n338# Cout VDD w_143_n351# CMOSP w=20 l=2
+  ad=100 pd=50 as=0 ps=0
M1016 C1 a_75_n113# VDD w_38_n97# CMOSP w=20 l=2
+  ad=160 pd=78 as=0 ps=0
M1017 a_174_n296# a_150_n274# VDD w_137_n280# CMOSP w=20 l=2
+  ad=100 pd=50 as=0 ps=0
M1018 a_44_n440# G2 a_51_n418# w_38_n424# CMOSP w=20 l=2
+  ad=100 pd=50 as=120 ps=52
M1019 a_n30_n314# A_2 gnd Gnd CMOSN w=40 l=2
+  ad=240 pd=92 as=0 ps=0
M1020 a_195_n452# Pout gnd Gnd CMOSN w=20 l=2
+  ad=200 pd=100 as=0 ps=0
M1021 gnd a_254_n361# a_250_n326# Gnd CMOSN w=20 l=2
+  ad=0 pd=0 as=80 ps=48
M1022 a_n101_n173# A_1 VDD w_n131_n245# CMOSP w=20 l=2
+  ad=100 pd=50 as=0 ps=0
M1023 gnd Pt3 P32 Gnd CMOSN w=10 l=2
+  ad=0 pd=0 as=100 ps=60
M1024 a_44_n222# G0 a_51_n200# w_38_n206# CMOSP w=20 l=2
+  ad=100 pd=50 as=120 ps=52
M1025 a_231_n296# C3 VDD w_137_n280# CMOSP w=20 l=2
+  ad=100 pd=50 as=0 ps=0
M1026 VDD G3 GPG3 w_38_n424# CMOSP w=20 l=2
+  ad=0 pd=0 as=120 ps=52
M1027 a_174_n187# a_150_n165# VDD w_137_n171# CMOSP w=20 l=2
+  ad=100 pd=50 as=0 ps=0
M1028 a_44_n331# G1 a_51_n309# w_38_n315# CMOSP w=20 l=2
+  ad=100 pd=50 as=120 ps=52
M1029 a_n30_n96# A_0 gnd Gnd CMOSN w=40 l=2
+  ad=240 pd=92 as=0 ps=0
M1030 a_n30_n205# A_1 gnd Gnd CMOSN w=40 l=2
+  ad=240 pd=92 as=0 ps=0
M1031 VDD G1 GPG1 w_38_n206# CMOSP w=20 l=2
+  ad=0 pd=0 as=120 ps=52
M1032 gnd a_254_n252# a_250_n217# Gnd CMOSN w=20 l=2
+  ad=0 pd=0 as=80 ps=48
M1033 gnd Pt2 P21 Gnd CMOSN w=10 l=2
+  ad=0 pd=0 as=100 ps=60
M1034 gnd a_174_n296# a_183_n296# Gnd CMOSN w=10 l=2
+  ad=0 pd=0 as=100 ps=60
M1035 a_250_n326# clk Cout Gnd CMOSN w=20 l=2
+  ad=0 pd=0 as=100 ps=50
M1036 a_231_n187# C2 VDD w_137_n171# CMOSP w=20 l=2
+  ad=100 pd=50 as=0 ps=0
M1037 VDD G2 GPG2 w_38_n315# CMOSP w=20 l=2
+  ad=0 pd=0 as=120 ps=52
M1038 gnd a_254_n143# a_250_n108# Gnd CMOSN w=20 l=2
+  ad=0 pd=0 as=80 ps=48
M1039 a_150_n383# P32 a_150_n415# Gnd CMOSN w=20 l=2
+  ad=100 pd=50 as=120 ps=52
M1040 gnd Pt1 P10 Gnd CMOSN w=10 l=2
+  ad=0 pd=0 as=100 ps=60
M1041 gnd a_174_n187# a_183_n187# Gnd CMOSN w=10 l=2
+  ad=0 pd=0 as=100 ps=60
M1042 a_44_n440# G2 gnd Gnd CMOSN w=10 l=2
+  ad=100 pd=60 as=0 ps=0
M1043 a_174_n296# a_150_n274# gnd Gnd CMOSN w=10 l=2
+  ad=50 pd=30 as=0 ps=0
M1044 a_n101_n64# A_0 VDD w_n131_n136# CMOSP w=20 l=2
+  ad=100 pd=50 as=0 ps=0
M1045 a_250_n217# clk S3 Gnd CMOSN w=20 l=2
+  ad=0 pd=0 as=100 ps=50
M1046 a_150_n165# P10 a_150_n197# Gnd CMOSN w=20 l=2
+  ad=100 pd=50 as=120 ps=52
M1047 a_174_n405# a_150_n383# gnd Gnd CMOSN w=10 l=2
+  ad=50 pd=30 as=0 ps=0
M1048 VDD a_278_n59# a_254_n59# w_243_n62# CMOSP w=20 l=2
+  ad=0 pd=0 as=100 ps=50
M1049 a_274_n326# clk a_254_n361# Gnd CMOSN w=20 l=2
+  ad=80 pd=48 as=100 ps=50
M1050 a_231_n296# C3 gnd Gnd CMOSN w=10 l=2
+  ad=70 pd=48 as=0 ps=0
M1051 a_150_n274# P21 a_150_n306# Gnd CMOSN w=20 l=2
+  ad=100 pd=50 as=120 ps=52
M1052 VDD B_0 G0 w_n131_n136# CMOSP w=40 l=2
+  ad=0 pd=0 as=240 ps=92
M1053 a_250_n108# clk S2 Gnd CMOSN w=20 l=2
+  ad=0 pd=0 as=100 ps=50
M1054 a_174_n187# a_150_n165# gnd Gnd CMOSN w=10 l=2
+  ad=50 pd=30 as=0 ps=0
M1055 pgxor1 C1 s_1 w_123_n108# CMOSP w=8 l=2
+  ad=125 pd=80 as=80 ps=52
M1056 VDD a_254_n361# Cout w_243_n364# CMOSP w=20 l=2
+  ad=0 pd=0 as=100 ps=50
M1057 a_231_n187# C2 gnd Gnd CMOSN w=10 l=2
+  ad=70 pd=48 as=0 ps=0
M1058 a_274_n217# clk a_254_n252# Gnd CMOSN w=20 l=2
+  ad=80 pd=48 as=100 ps=50
M1059 a_195_n452# Pout a_195_n460# w_189_n473# CMOSP w=40 l=2
+  ad=200 pd=90 as=240 ps=92
M1060 a_152_n23# clk S0 Gnd CMOSN w=20 l=2
+  ad=80 pd=48 as=100 ps=50
M1061 VDD S2 a_189_n117# w_205_n123# CMOSP w=20 l=2
+  ad=0 pd=0 as=100 ps=50
M1062 a_136_n124# C1 VDD w_123_n108# CMOSP w=20 l=2
+  ad=100 pd=50 as=0 ps=0
M1063 VDD a_254_n252# S3 w_137_n280# CMOSP w=20 l=2
+  ad=0 pd=0 as=100 ps=50
M1064 Gout GPG3 gnd Gnd CMOSN w=20 l=2
+  ad=200 pd=100 as=0 ps=0
M1065 a_51_n91# Pt0 VDD w_38_n97# CMOSP w=40 l=2
+  ad=240 pd=92 as=0 ps=0
M1066 a_274_n108# clk a_254_n143# Gnd CMOSN w=20 l=2
+  ad=80 pd=48 as=100 ps=50
M1067 pgxor0 B_0 a_n101_n64# Gnd CMOSN w=4 l=2
+  ad=40 pd=36 as=70 ps=48
M1068 VDD G0 C1 w_38_n97# CMOSP w=20 l=2
+  ad=0 pd=0 as=0 ps=0
M1069 pgxor1 a_136_n124# s_1 Gnd CMOSN w=4 l=2
+  ad=69 pd=58 as=40 ps=36
M1070 VDD a_254_n143# S2 w_137_n171# CMOSP w=20 l=2
+  ad=0 pd=0 as=100 ps=50
M1071 gnd C4 a_300_n381# Gnd CMOSN w=10 l=2
+  ad=0 pd=0 as=50 ps=30
M1072 VDD P32 a_150_n383# w_137_n389# CMOSP w=20 l=2
+  ad=0 pd=0 as=120 ps=52
M1073 a_91_n341# a_75_n331# gnd Gnd CMOSN w=20 l=2
+  ad=120 pd=52 as=0 ps=0
M1074 C4 a_216_n386# a_257_n392# Gnd CMOSN w=20 l=2
+  ad=100 pd=50 as=120 ps=52
M1075 gnd a_180_n58# a_176_n23# Gnd CMOSN w=20 l=2
+  ad=0 pd=0 as=80 ps=48
M1076 a_136_n124# C1 gnd Gnd CMOSN w=10 l=2
+  ad=70 pd=48 as=0 ps=0
M1077 VDD s_1 a_318_n76# w_243_n62# CMOSP w=40 l=2
+  ad=0 pd=0 as=160 ps=88
M1078 a_91_n232# a_75_n222# gnd Gnd CMOSN w=20 l=2
+  ad=120 pd=52 as=0 ps=0
M1079 gnd s_3 a_300_n272# Gnd CMOSN w=10 l=2
+  ad=0 pd=0 as=50 ps=30
M1080 pgxor0 B_0 A_0 w_n47_n53# CMOSP w=8 l=2
+  ad=0 pd=0 as=40 ps=26
M1081 VDD P21 a_150_n274# w_137_n280# CMOSP w=20 l=2
+  ad=0 pd=0 as=0 ps=0
M1082 gnd Pt0 a_44_n123# Gnd CMOSN w=20 l=2
+  ad=0 pd=0 as=200 ps=100
M1083 P32 Pt2 a_76_n374# w_38_n424# CMOSP w=20 l=2
+  ad=100 pd=50 as=120 ps=52
M1084 a_183_n296# GPG2 a_190_n274# w_137_n280# CMOSP w=20 l=2
+  ad=100 pd=50 as=0 ps=0
M1085 gnd C0bar a_195_n452# Gnd CMOSN w=20 l=2
+  ad=0 pd=0 as=0 ps=0
M1086 VDD a_216_n386# C4 w_137_n389# CMOSP w=20 l=2
+  ad=0 pd=0 as=120 ps=52
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
