VedantPahariya/VLSI-Carry-Look-Ahead-Adder/(commit log)

2024-11-12 more efficient circuit! 479ps
2024-11-13 added complete magic circuit
